scrpi/Fuzix-Compiler-Kit/docs/reference/isa-comparison.md

# BLIP ISA - cross-architecture syntax comparison

> **Non-normative.** A reference aid, not part of the justification chain (see [AGENTS.md](../AGENTS.md)). It names external architectures only for *syntax comparison*; nothing here justifies a BLIP decision.

Every BLIP opcode byte `0x00`-`0xFF` is listed; unused/reserved bytes show `-`. **Proposed** holds the agreed restyling of the BLIP cell (blank = no change); the rules are in the [Proposed](#proposed) section. Each used opcode is also translated into six other assembly languages, matched to that opcode's BLIP addressing mode.

**Legend:** `≈` = closest faithful multi-instruction equivalent; `—` = the ISA cannot express it directly. BLIP / 6502 / STM8 / Magic-1 use `$`-hex; 8080 / 8086 use Intel trailing-`h` hex. Generated from [isa.md](isa.md) §8; foreign columns adversarially cross-checked.

| Opcode | Operation | BLIP | Proposed | Z80 | STM8 | 6502 | Magic-1 | 8080 | 8086 |
|---|---|---|---|---|---|---|---|---|---|
| `0x00` | No-op | `NOP` | | `NOP` | `NOP` | `NOP` | `—` | `NOP` | `NOP` |
| `0x01` | Sync (priv) | `SYNC` | | `—` | `≈ WFI` | `—` | `—` | `—` | `—` |
| `0x02` | Decimal adjust | `DAA` | | `DAA` | `—` | `—` | `—` | `DAA` | `DAA` |
| `0x03` | Sign-extend B→A | `SEX` | | `≈ LD A,B:RLA:SBC A,A` | `≈ SEX X,A (B in A→XH=sign)` | `≈ LDA #0:CPX #$80:BCC +:LDA #$FF` | `sex a` | `≈ MOV A,B:RAL:SBB A` | `≈ CBW (B in AL)` |
| `0x04` | Multiply 8×8 (A*B→D) | `MUL` | | `—` | `MUL X,A` | `—` | `—` | `—` | `MUL BL` |
| `0x05` | Add B to X | `ABX` | | `≈ LD D,0:LD E,B:ADD IX,DE` | `≈ (B zero-ext→Y):ADDW X,Y(via mem)` | `—` | `≈ add.16 a,b (b zero-ext)` | `≈ MVI D,0:MOV E,B:DAD D` | `≈ MOV BH,0:ADD SI,BX` |
| `0x06` | Transfer reg→reg | `TFR D,X` | `LD X,D` | `≈ LD H,A:LD L,B:PUSH HL:POP IX` | `≈ LD XH,A:LD XL,B` | `—` | `≈ ld.16 a,b` | `≈ MOV H,A:MOV L,B` | `MOV SI,AX` |
| `0x07` | Exchange regs | `EXG A,B` | `XCHG A,B` | `≈ LD C,A:LD A,B:LD B,C` | `≈ EXG A,XL (B≈XL)` | `≈ STA t:TXA:LDX t (B≈X)` | `≈ ld.8 c,a:ld.8 a,b:ld.8 b,c` | `≈ MOV C,A:MOV A,B:MOV B,C` | `XCHG AL,BL` |
| `0x08` | Push register set | `PSHS A,B,X` | | `≈ PUSH AF:PUSH BC:PUSH IX` | `≈ PUSH A:(B→A:PUSH A):PUSHW X` | `≈ PHA:(B→A:PHA):TXA:PHA` | `≈ st.8 (sp),a;st.8 (sp),b;st.16 (sp),x` | `≈ PUSH PSW:PUSH B:PUSH H` | `≈ PUSH AX:PUSH BX:PUSH SI` |
| `0x09` | Pull register set | `PULS A,B,X` | | `≈ POP IX:POP BC:POP AF` | `≈ POPW X:(POP A→B):POP A` | `≈ PLA:TAX:(PLA→B):PLA` | `≈ ld.16 x,(sp);ld.8 b,(sp);ld.8 a,(sp)` | `≈ POP H:POP B:POP PSW` | `≈ POP SI:POP BX:POP AX` |
| `0x0A` | AND into CC | `ANDCC #$EF` | `ANDCC $EF` | `≈ PUSH AF:POP BC:LD A,C:AND $EF:LD C,A:PUSH BC:POP AF` | `≈ PUSH CC:POP A:AND A,#$EF:PUSH A:POP CC` | `≈ PHP:PLA:AND #$EF:PHA:PLP` | `≈ (MSW: and $EF)` | `≈ PUSH PSW:POP H:MOV A,L:ANI 0EFh:MOV L,A:PUSH H:POP PSW` | `≈ PUSHF:POP AX:AND AX,0FFEFh:PUSH AX:POPF` |
| `0x0B` | OR into CC | `ORCC #$10` | `ORCC $10` | `≈ PUSH AF:POP BC:LD A,C:OR $10:LD C,A:PUSH BC:POP AF` | `≈ PUSH CC:POP A:OR A,#$10:PUSH A:POP CC` | `≈ PHP:PLA:ORA #$10:PHA:PLP` | `≈ (MSW: or $10)` | `≈ PUSH PSW:POP H:MOV A,L:ORI 10h:MOV L,A:PUSH H:POP PSW`  | `≈ PUSHF:POP AX:OR AX,10h:PUSH AX:POPF` |
| `0x0C` | Mask interrupts (priv) | `SEI` | | `DI` | `SIM` | `SEI` | `≈ (MSW mask interrupts)` | `DI` | `CLI` |
| `0x0D` | Unmask interrupts (priv) | `CLI` | | `EI` | `RIM` | `CLI` | `≈ (MSW unmask interrupts)` | `EI` | `STI` |
| `0x0E` | - | - | | - | - | - | - | - | - |
| `0x0F` | - | - | | - | - | - | - | - | - |
| `0x10` | Return from subroutine | `RTS` | | `RET` | `RET` | `RTS` | `ret` | `RET` | `RET` |
| `0x11` | Return from interrupt (priv) | `RTI` | | `RETI` | `IRET` | `RTI` | `reti` | `≈ EI:RET` | `IRET` |
| `0x12` | Software trap | `SWI` | | `RST $38` | `TRAP` | `BRK` | `syscall 0` | `RST 7` | `INT 3` |
| `0x13` | Software trap 2 | `SWI2` | | `≈ RST $30` | `—` | `—` | `syscall 1` | `≈ RST 6` | `INT n` |
| `0x14` | Software trap 3 | `SWI3` | | `≈ RST $28` | `—` | `—` | `syscall 2` | `≈ RST 5` | `INT n` |
| `0x15` | Wait, clear CC mask | `CWAI #$EF` | `CWAI $EF` | `≈ (ANDCC $EF):HALT` | `≈ (ANDCC $EF):WFI` | `—` | `≈ (MSW: and $EF):halt` | `≈ EI:HLT` | `≈ STI:HLT` |
| `0x16` | Branch to subroutine | `BSR lbl` | | `CALL lbl` | `CALLR lbl` | `JSR lbl` | `call lbl` | `CALL lbl` | `CALL lbl` |
| `0x17` | Long branch to subroutine | `LBSR lbl` | | `CALL lbl` | `CALL lbl` | `JSR lbl` | `call lbl` | `CALL lbl` | `CALL lbl` |
| `0x18` | Halt (priv) | `HALT` | | `HALT` | `HALT` | `—` | `halt` | `HLT` | `HLT` |
| `0x19` | Test-and-set (atomic) | `TAS ,X` | `TAS (X)` | `—` | `—` | `—` | `ldclr a,(b)` | `—` | `≈ MOV AL,1:LOCK XCHG [BX],AL` |
| `0x1A` | Bank USP via TFR (priv) | `TFRU` | `LD USP,X` | `—` | `—` | `—` | `≈ ld ssp,a` | `—` | `—` |
| `0x1B` | Bank USP via EXG (priv) | `EXGU` | `XCHG X,USP` | `—` | `—` | `—` | `≈ (exch ssp,a via temp)` | `—` | `—` |
| `0x1C` | Load MMU entry (priv) | `LDMMU #2` | `LDMMU $2` | `—` | `—` | `—` | `≈ ld ptb,a / wcpte a,(b)` | `—` | `—` |
| `0x1D` | Store MMU entry (priv) | `STMMU #2` | `STMMU $2` | `—` | `—` | `—` | `—` | `—` | `—` |
| `0x1E` | - | - | | - | - | - | - | - | - |
| `0x1F` | - | - | | - | - | - | - | - | - |
| `0x20` | Branch always | `BRA lbl` | | `JR lbl` | `JRA lbl` | `JMP lbl` | `br lbl` | `JMP lbl` | `JMP lbl` |
| `0x21` | Branch never | `BRN lbl` | | `— (never)` | `JRF lbl` | `— (never)` | `— (no never)` | `— (never)` | `— (never)` |
| `0x22` | Branch unsigned &gt; | `BHI lbl` | | `—` | `JRUGT lbl` | `—` | `br.gtu lbl` | `≈ JC skip:JZ skip:JMP lbl` | `JA lbl` |
| `0x23` | Branch unsigned ≤ | `BLS lbl` | | `—` | `JRULE lbl` | `—` | `br.leu lbl` | `≈ JC lbl:JZ lbl` | `JBE lbl` |
| `0x24` | Branch carry clear (uns ≥) | `BCC lbl` | | `JR NC,lbl` | `JRNC lbl` | `BCC lbl` | `br.geu lbl` | `JNC lbl` | `JAE lbl` |
| `0x25` | Branch carry set (uns &lt;) | `BCS lbl` | | `JR C,lbl` | `JRC lbl` | `BCS lbl` | `br.ltu lbl` | `JC lbl` | `JB lbl` |
| `0x26` | Branch not equal | `BNE lbl` | | `JR NZ,lbl` | `JRNE lbl` | `BNE lbl` | `br.ne lbl` | `JNZ lbl` | `JNE lbl` |
| `0x27` | Branch equal | `BEQ lbl` | | `JR Z,lbl` | `JREQ lbl` | `BEQ lbl` | `br.eq lbl` | `JZ lbl` | `JE lbl` |
| `0x28` | Branch overflow clear | `BVC lbl` | | `JP PO,lbl` | `JRNV lbl` | `BVC lbl` | `—` | `JPO lbl` | `JNO lbl` |
| `0x29` | Branch overflow set | `BVS lbl` | | `JP PE,lbl` | `JRV lbl` | `BVS lbl` | `—` | `JPE lbl` | `JO lbl` |
| `0x2A` | Branch plus | `BPL lbl` | | `JP P,lbl` | `JRPL lbl` | `BPL lbl` | `≈ br.ge lbl` | `JP lbl` | `JNS lbl` |
| `0x2B` | Branch minus | `BMI lbl` | | `JP M,lbl` | `JRMI lbl` | `BMI lbl` | `≈ br.lt lbl` | `JM lbl` | `JS lbl` |
| `0x2C` | Branch signed ≥ | `BGE lbl` | | `—` | `JRSGE lbl` | `—` | `br.ge lbl` | `—` | `JGE lbl` |
| `0x2D` | Branch signed &lt; | `BLT lbl` | | `—` | `JRSLT lbl` | `—` | `br.lt lbl` | `—` | `JL lbl` |
| `0x2E` | Branch signed &gt; | `BGT lbl` | | `—` | `JRSGT lbl` | `—` | `br.gt lbl` | `—` | `JG lbl` |
| `0x2F` | Branch signed ≤ | `BLE lbl` | | `—` | `JRSLE lbl` | `—` | `br.le lbl` | `—` | `JLE lbl` |
| `0x30` | Load eff. addr → X | `LEAX 4,X` | `LEA X,X+4` | `≈ LD DE,4:ADD IX,DE` | `ADDW X,#4` | `—` | `lea a,(a+4)` | `≈ LXI D,4:DAD D (HL≈X)` | `LEA BX,[BX+4]` |
| `0x31` | Load eff. addr → Y | `LEAY 4,Y` | `LEA Y,Y+4` | `≈ LD DE,4:ADD IY,DE` | `ADDW Y,#4` | `—` | `lea a,(a+4)` | `—` | `LEA DI,[DI+4]` |
| `0x32` | Adjust SP | `LEASP -8,SP`  | `LEA SP,SP-8` | `≈ LD HL,-8:ADD HL,SP:LD SP,HL` | `—` | `≈ TSX:DEX×8:TXS` | `≈ sub.16 sp,$08` | `≈ LXI H,-8:DAD SP:SPHL` | `SUB SP,8` |
| `0x33` | Compare D (imm) | `CMPD #$1000`  | `CMP D,$1000` | `—` | `≈ LDW X,D:CPW X,#$1000` | `—` | `≈ ld.16 a,d:cmp.16 a,$1000` | `—` | `CMP DX,1000h` |
| `0x34` | Compare Y (imm) | `CMPY #$1000`  | `CMP Y,$1000` | `—` | `CPW Y,#$1000` | `—` | `≈ ld.16 a,y:cmp.16 a,$1000` | `—` | `CMP DI,1000h` |
| `0x35` | Compare SP (imm) | `CMPSP #$1000` | `CMP SP,$1000` | `—` | `—` | `—` | `≈ ld.16 a,sp:cmp.16 a,$1000` | `—` | `CMP SP,1000h` |
| `0x36` | Jump (indexed) | `JMP ,X` | `JMP X` | `JP (IX)` | `JP (X)` | `—` | `≈ br a` | `PCHL (HL≈X)` | `JMP BX` |
| `0x37` | Jump (extended) | `JMP $1234` | | `JP $1234` | `JP $1234` | `JMP $1234` | `br $1234` | `JMP 1234h` | `JMP 1234h` |
| `0x38` | Compare D (indexed) | `CMPD 6,X` | `CMP D,(X+6)` | `—` | `≈ LDW Y,D:CPW Y,(6,X)` | `—` | `≈ ld.16 a,d:cmp.16 a,(b+6)` | `—` | `CMP DX,[BX+6]` |
| `0x39` | Compare D (extended) | `CMPD $1234` | `CMP D,($1234)`  | `—` | `≈ LDW X,D:CPW X,$1234` | `—` | `≈ ld.16 a,d:cmp.16 a,(dp+$1234)` | `—` | `CMP DX,[1234h]` |
| `0x3A` | Compare Y (indexed) | `CMPY 6,X` | `CMP Y,(X+6)` | `—` | `CPW Y,(6,X)` | `—` | `≈ ld.16 a,y:cmp.16 a,(b+6)` | `—` | `CMP DI,[BX+6]` |
| `0x3B` | Compare Y (extended) | `CMPY $1234` | `CMP Y,($1234)`  | `—` | `CPW Y,$1234` | `—` | `≈ ld.16 a,y:cmp.16 a,(dp+$1234)` | `—` | `CMP DI,[1234h]` |
| `0x3C` | Compare SP (indexed) | `CMPSP 6,X` | `CMP SP,(X+6)` | `—` | `—` | `—` | `≈ ld.16 a,sp:cmp.16 a,(b+6)` | `—` | `CMP SP,[BX+6]` |
| `0x3D` | Compare SP (extended) | `CMPSP $1234`  | `CMP SP,($1234)` | `—` | `—` | `—` | `≈ ld.16 a,sp:cmp.16 a,(dp+$1234)` | `—` | `CMP SP,[1234h]` |
| `0x3E` | - | - | | - | - | - | - | - | - |
| `0x3F` | - | - | | - | - | - | - | - | - |
| `0x40` | Negate A | `NEGA` | `NEG A` | `NEG` | `NEG A` | `≈ EOR #$FF:CLC:ADC #1` | `≈ xor.8 a,$FF:add.8 a,$01` | `≈ CMA:INR A` | `NEG AL` |
| `0x41` | - | - | | - | - | - | - | - | - |
| `0x42` | - | - | | - | - | - | - | - | - |
| `0x43` | Complement A | `COMA` | `COM A` | `CPL` | `CPL A` | `EOR #$FF` | `xor.8 a,$FF` | `CMA` | `NOT AL` |
| `0x44` | Logical shift right A | `LSRA` | `LSR A` | `SRL A` | `SRL A` | `LSR A` | `shr.8 a,$01` | `≈ ORA A:RAR` | `SHR AL,1` |
| `0x45` | - | - | | - | - | - | - | - | - |
| `0x46` | Rotate right thru C A | `RORA` | `ROR A` | `RR A` | `RRC A` | `ROR A` | `—` | `RAR` | `RCR AL,1` |
| `0x47` | Arith shift right A | `ASRA` | `ASR A` | `SRA A` | `SRA A` | `—` | `—` | `≈ rotates` | `SAR AL,1` |
| `0x48` | Shift left A | `ASLA` | `ASL A` | `SLA A` | `SLL A` | `ASL A` | `shl.8 a,$01` | `≈ ADD A` | `SHL AL,1` |
| `0x49` | Rotate left thru C A | `ROLA` | `ROL A` | `RL A` | `RLC A` | `ROL A` | `—` | `RAL` | `RCL AL,1` |
| `0x4A` | Decrement A | `DECA` | `DEC A` | `DEC A` | `DEC A` | `≈ TAX:DEX:TXA` | `≈ sub.8 a,$01` | `DCR A` | `DEC AL` |
| `0x4B` | - | - | | - | - | - | - | - | - |
| `0x4C` | Increment A | `INCA` | `INC A` | `INC A` | `INC A` | `≈ TAX:INX:TXA` | `≈ add.8 a,$01` | `INR A` | `INC AL` |
| `0x4D` | Test (set N,Z) A | `TSTA` | `TST A` | `OR A` | `TNZ A` | `≈ CMP #0` | `≈ cmp.8 a,$00` | `ORA A` | `TEST AL,AL` |
| `0x4E` | - | - | | - | - | - | - | - | - |
| `0x4F` | Clear A | `CLRA` | `CLR A` | `XOR A` | `CLR A` | `LDA #0` | `ld.8 a,$00` | `XRA A` | `XOR AL,AL` |
| `0x50` | Negate B | `NEGB` | `NEG B` | `≈ LD A,B:NEG:LD B,A` | `≈ NEG A` | `≈ TXA:EOR #$FF:CLC:ADC #1:TAX` | `≈ xor.8 b,$FF:add.8 b,$01` | `≈ MOV A,B:CMA:INR A:MOV B,A` | `NEG BL` |
| `0x51` | - | - | | - | - | - | - | - | - |
| `0x52` | - | - | | - | - | - | - | - | - |
| `0x53` | Complement B | `COMB` | `COM B` | `≈ LD A,B:CPL:LD B,A` | `≈ CPL A` | `≈ TXA:EOR #$FF:TAX` | `xor.8 b,$FF` | `≈ MOV A,B:CMA:MOV B,A` | `NOT BL` |
| `0x54` | Logical shift right B | `LSRB` | `LSR B` | `≈ LD A,B:SRL A:LD B,A` | `≈ SRL A` | `≈ TXA:LSR A:TAX` | `shr.8 b,$01` | `≈ MOV A,B:ORA A:RAR:MOV B,A` | `SHR BL,1` |
| `0x55` | - | - | | - | - | - | - | - | - |
| `0x56` | Rotate right thru C B | `RORB` | `ROR B` | `≈ LD A,B:RR A:LD B,A` | `≈ RRC A` | `≈ TXA:ROR A:TAX` | `—` | `≈ MOV A,B:RAR:MOV B,A` | `RCR BL,1` |
| `0x57` | Arith shift right B | `ASRB` | `ASR B` | `≈ LD A,B:SRA A:LD B,A` | `≈ SRA A` | `—` | `—` | `≈ rotates` | `SAR BL,1` |
| `0x58` | Shift left B | `ASLB` | `ASL B` | `≈ LD A,B:SLA A:LD B,A` | `≈ SLL A` | `≈ TXA:ASL A:TAX` | `shl.8 b,$01` | `≈ MOV A,B:ADD A:MOV B,A` | `SHL BL,1` |
| `0x59` | Rotate left thru C B | `ROLB` | `ROL B` | `≈ LD A,B:RL A:LD B,A` | `≈ RLC A` | `≈ TXA:ROL A:TAX` | `—` | `≈ MOV A,B:RAL:MOV B,A` | `RCL BL,1` |
| `0x5A` | Decrement B | `DECB` | `DEC B` | `DEC B` | `≈ DEC A` | `DEX` | `≈ sub.8 b,$01` | `DCR B` | `DEC BL` |
| `0x5B` | - | - | | - | - | - | - | - | - |
| `0x5C` | Increment B | `INCB` | `INC B` | `INC B` | `≈ INC A` | `INX` | `≈ add.8 b,$01` | `INR B` | `INC BL` |
| `0x5D` | Test (set N,Z) B | `TSTB` | `TST B` | `≈ LD A,B:OR A` | `≈ TNZ A` | `≈ CPX #0` | `≈ cmp.8 b,$00` | `≈ MOV A,B:ORA A` | `TEST BL,BL` |
| `0x5E` | - | - | | - | - | - | - | - | - |
| `0x5F` | Clear B | `CLRB` | `CLR B` | `≈ LD B,0` | `≈ CLR A` | `LDX #0` | `ld.8 b,$00` | `MVI B,0` | `XOR BL,BL` |
| `0x60` | Negate (indexed) | `NEG 6,X` | `NEG (X+6)` | `≈ LD A,(IX+6):NEG:LD (IX+6),A` | `NEG (6,X)` | `≈ SEC:LDA $06,X:EOR #$FF:ADC #1:STA $06,X` | `≈ ld.8 a,$00:sub.8 a,(b+6):st.8 (b+6),a` | `≈ LXI H,..:MOV A,M:CMA:INR A:MOV M,A` | `NEG byte [BX+6]` |
| `0x61` | - | - | | - | - | - | - | - | - |
| `0x62` | - | - | | - | - | - | - | - | - |
| `0x63` | Complement (indexed) | `COM 6,X` | `COM (X+6)` | `≈ LD A,(IX+6):CPL:LD (IX+6),A` | `CPL (6,X)` | `≈ LDA $06,X:EOR #$FF:STA $06,X` | `≈ ld.8 a,(b+6):xor.8 a,$FF:st.8 (b+6),a` | `≈ LXI H,..:MOV A,M:CMA:MOV M,A` | `NOT byte [BX+6]` |
| `0x64` | Logical shift right (indexed) | `LSR 6,X` | `LSR (X+6)` | `SRL (IX+6)` | `SRL (6,X)` | `LSR $06,X` | `≈ ld.8 a,(b+6):shr.8 a:st.8 (b+6),a` | `≈ LXI H,..:MOV A,M:ORA A:RAR:MOV M,A` | `SHR byte [BX+6],1` |
| `0x65` | - | - | | - | - | - | - | - | - |
| `0x66` | Rotate right thru C (indexed) | `ROR 6,X` | `ROR (X+6)` | `RR (IX+6)` | `RRC (6,X)` | `ROR $06,X` | `—` | `≈ LXI H,..:MOV A,M:RAR:MOV M,A` | `RCR byte [BX+6],1` |
| `0x67` | Arith shift right (indexed) | `ASR 6,X` | `ASR (X+6)` | `SRA (IX+6)` | `SRA (6,X)` | `—` | `≈ shr.8 then restore sign bit` | `≈ rotates (no SAR)` | `SAR byte [BX+6],1` |
| `0x68` | Shift left (indexed) | `ASL 6,X` | `ASL (X+6)` | `SLA (IX+6)` | `SLL (6,X)` | `ASL $06,X` | `≈ ld.8 a,(b+6):shl.8 a:st.8 (b+6),a` | `≈ LXI H,..:MOV A,M:ADD A:MOV M,A` | `SHL byte [BX+6],1` |
| `0x69` | Rotate left thru C (indexed) | `ROL 6,X` | `ROL (X+6)` | `RL (IX+6)` | `RLC (6,X)` | `ROL $06,X` | `—` | `≈ LXI H,..:MOV A,M:RAL:MOV M,A` | `RCL byte [BX+6],1` |
| `0x6A` | Decrement (indexed) | `DEC 6,X` | `DEC (X+6)` | `DEC (IX+6)` | `DEC (6,X)` | `DEC $06,X` | `≈ ld.8 a,(b+6):sub.8 a,$01:st.8 (b+6),a` | `≈ LXI H,..:DCR M` | `DEC byte [BX+6]` |
| `0x6B` | - | - | | - | - | - | - | - | - |
| `0x6C` | Increment (indexed) | `INC 6,X` | `INC (X+6)` | `INC (IX+6)` | `INC (6,X)` | `INC $06,X` | `≈ ld.8 a,(b+6):add.8 a,$01:st.8 (b+6),a` | `≈ LXI H,..:INR M` | `INC byte [BX+6]` |
| `0x6D` | Test (set N,Z) (indexed) | `TST 6,X` | `TST (X+6)` | `≈ LD A,(IX+6):OR A` | `TNZ (6,X)` | `≈ LDA $06,X (sets N,Z)` | `≈ ld.8 a,(b+6):or.8 a,a` | `≈ LXI H,..:MOV A,M:ORA A` | `≈ MOV AL,[BX+6]:TEST AL,AL` |
| `0x6E` | - | - | | - | - | - | - | - | - |
| `0x6F` | Clear (indexed) | `CLR 6,X` | `CLR (X+6)` | `≈ LD (IX+6),0` | `CLR (6,X)` | `≈ LDA #0:STA $06,X` | `≈ ld.8 a,$00:st.8 (b+6),a` | `≈ LXI H,..:MVI M,0` | `MOV byte [BX+6],0` |
| `0x70` | Negate (extended) | `NEG $1234` | `NEG ($1234)` | `≈ LD A,($1234):NEG:LD ($1234),A` | `NEG $1234` | `≈ SEC:LDA $1234:EOR #$FF:ADC #1:STA $1234` | `≈ ld.8 a,$00:sub.8 a,(dp+$1234):st.8 (dp+$1234),a` | `≈ LDA $1234:CMA:INR A:STA $1234` | `NEG byte [1234h]` |
| `0x71` | - | - | | - | - | - | - | - | - |
| `0x72` | - | - | | - | - | - | - | - | - |
| `0x73` | Complement (extended) | `COM $1234` | `COM ($1234)` | `≈ LD A,($1234):CPL:LD ($1234),A` | `CPL $1234` | `≈ LDA $1234:EOR #$FF:STA $1234` | `≈ ld.8 a,(dp+$1234):xor.8 a,$FF:st.8 (dp+$1234),a` | `≈ LDA $1234:CMA:STA $1234` | `NOT byte [1234h]` |
| `0x74` | Logical shift right (extended) | `LSR $1234` | `LSR ($1234)` | `≈ LD HL,$1234:SRL (HL)` | `SRL $1234` | `LSR $1234` | `≈ ld.8 a,(dp+$1234):shr.8 a:st.8 (dp+$1234),a` | `≈ LDA $1234:ORA A:RAR:STA $1234` | `SHR byte [1234h],1` |
| `0x75` | - | - | | - | - | - | - | - | - |
| `0x76` | Rotate right thru C (extended) | `ROR $1234` | `ROR ($1234)` | `≈ LD HL,$1234:RR (HL)` | `RRC $1234` | `ROR $1234` | `—` | `≈ LDA $1234:RAR:STA $1234` | `RCR byte [1234h],1` |
| `0x77` | Arith shift right (extended) | `ASR $1234` | `ASR ($1234)` | `≈ LD HL,$1234:SRA (HL)` | `SRA $1234` | `—` | `≈ shr.8 then restore sign bit` | `≈ rotates (no SAR)` | `SAR byte [1234h],1` |
| `0x78` | Shift left (extended) | `ASL $1234` | `ASL ($1234)` | `≈ LD HL,$1234:SLA (HL)` | `SLL $1234` | `ASL $1234` | `≈ ld.8 a,(dp+$1234):shl.8 a:st.8 (dp+$1234),a` | `≈ LDA $1234:ADD A:STA $1234` | `SHL byte [1234h],1` |
| `0x79` | Rotate left thru C (extended) | `ROL $1234` | `ROL ($1234)` | `≈ LD HL,$1234:RL (HL)` | `RLC $1234` | `ROL $1234` | `—` | `≈ LDA $1234:RAL:STA $1234` | `RCL byte [1234h],1` |
| `0x7A` | Decrement (extended) | `DEC $1234` | `DEC ($1234)` | `≈ LD HL,$1234:DEC (HL)` | `DEC $1234` | `DEC $1234` | `≈ ld.8 a,(dp+$1234):sub.8 a,$01:st.8 (dp+$1234),a` | `≈ LXI H,$1234:DCR M` | `DEC byte [1234h]` |
| `0x7B` | - | - | | - | - | - | - | - | - |
| `0x7C` | Increment (extended) | `INC $1234` | `INC ($1234)` | `≈ LD HL,$1234:INC (HL)` | `INC $1234` | `INC $1234` | `≈ ld.8 a,(dp+$1234):add.8 a,$01:st.8 (dp+$1234),a` | `≈ LXI H,$1234:INR M` | `INC byte [1234h]` |
| `0x7D` | Test (set N,Z) (extended) | `TST $1234` | `TST ($1234)` | `≈ LD A,($1234):OR A` | `TNZ $1234` | `≈ LDA $1234 (sets N,Z)` | `≈ ld.8 a,(dp+$1234):or.8 a,a` | `≈ LDA $1234:ORA A` | `≈ MOV AL,[1234h]:TEST AL,AL` |
| `0x7E` | - | - | | - | - | - | - | - | - |
| `0x7F` | Clear (extended) | `CLR $1234` | `CLR ($1234)` | `≈ LD HL,$1234:LD (HL),0` | `CLR $1234` | `≈ LDA #0:STA $1234` | `≈ ld.8 a,$00:st.8 (dp+$1234),a` | `≈ XRA A:STA $1234` | `MOV byte [1234h],0` |
| `0x80` | Subtract A (imm) | `SUBA #$05` | `SUB A,$05` | `SUB $05` | `SUB A,#$05` | `≈ SEC:SBC #$05` | `sub.8 a,$05` | `SUI 05h` | `SUB AL,5` |
| `0x81` | Compare A (imm) | `CMPA #$05` | `CMP A,$05` | `CP $05` | `CP A,#$05` | `CMP #$05` | `cmp.8 a,$05` | `CPI 05h` | `CMP AL,5` |
| `0x82` | Sub-borrow A (imm) | `SBCA #$05` | `SBC A,$05` | `SBC A,$05` | `SBC A,#$05` | `SBC #$05` | `sbc.8 a,$05` | `SBI 05h` | `SBB AL,5` |
| `0x83` | Subtract D (imm) | `SUBD #$1000`  | `SUB D,$1000` | `≈ LD DE,$1000:OR A:SBC HL,DE` | `SUBW X,#$1000` | `—` | `sub.16 a,$1000` | `—` | `SUB AX,1000h` |
| `0x84` | AND A (imm) | `ANDA #$05` | `AND A,$05` | `AND $05` | `AND A,#$05` | `AND #$05` | `and.8 a,$05` | `ANI 05h` | `AND AL,5` |
| `0x85` | Bit test A (imm) | `BITA #$05` | `BIT A,$05` | `AND $05` | `BCP A,#$05` | `—` | `and.8 a,$05` | `ANI 05h` | `TEST AL,5` |
| `0x86` | Load A (imm) | `LDA #$05` | `LD A,$05` | `LD A,$05` | `LD A,#$05` | `LDA #$05` | `ld.8 a,$05` | `MVI A,05h` | `MOV AL,5` |
| `0x87` | - | - | | - | - | - | - | - | - |
| `0x88` | EOR A (imm) | `EORA #$05` | `EOR A,$05` | `XOR $05` | `XOR A,#$05` | `EOR #$05` | `xor.8 a,$05` | `XRI 05h` | `XOR AL,5` |
| `0x89` | Add-carry A (imm) | `ADCA #$05` | `ADC A,$05` | `ADC A,$05` | `ADC A,#$05` | `≈ ADC #$05 (carry-add)` | `adc.8 a,$05` | `ACI 05h` | `ADC AL,5` |
| `0x8A` | OR A (imm) | `ORA #$05` | `OR A,$05` | `OR $05` | `OR A,#$05` | `ORA #$05` | `or.8 a,$05` | `ORI 05h` | `OR AL,5` |
| `0x8B` | Add A (imm) | `ADDA #$05` | `ADD A,$05` | `ADD A,$05` | `ADD A,#$05` | `≈ CLC:ADC #$05` | `add.8 a,$05` | `ADI 05h` | `ADD AL,5` |
| `0x8C` | Compare X (imm) | `CMPX #$1000`  | `CMP X,$1000` | `—` | `CPW X,#$1000` | `—` | `cmp.16 a,$1000` | `—` | `CMP AX,1000h` |
| `0x8D` | - | - | | - | - | - | - | - | - |
| `0x8E` | Load X (imm) | `LDX #$1234` | `LD X,$1234` | `LD IX,$1234` | `LDW X,#$1234` | `—` | `ld.16 a,$1234` | `LXI H,1234h` | `MOV SI,1234h` |
| `0x8F` | - | - | | - | - | - | - | - | - |
| `0x90` | Subtract A (indexed) | `SUBA 6,X` | `SUB A,(X+6)` | `SUB (IX+6)` | `SUB A,(6,X)` | `≈ SEC:SBC $06,X` | `≈ ld.8 b,(b+6):sub.8 a,b` | `≈ LXI H,addr:SUB M` | `SUB AL,[SI+6]` |
| `0x91` | Compare A (indexed) | `CMPA 6,X` | `CMP A,(X+6)` | `CP (IX+6)` | `CP A,(6,X)` | `CMP $06,X` | `≈ ld.8 b,(b+6):cmp.8 a,b` | `≈ LXI H,addr:CMP M` | `CMP AL,[SI+6]` |
| `0x92` | Sub-borrow A (indexed) | `SBCA 6,X` | `SBC A,(X+6)` | `SBC A,(IX+6)` | `SBC A,(6,X)` | `SBC $06,X` | `≈ ld.8 b,(b+6):sbc.8 a,b` | `≈ LXI H,addr:SBB M` | `SBB AL,[SI+6]` |
| `0x93` | Subtract D (indexed) | `SUBD 6,X` | `SUB D,(X+6)` | `—` | `SUBW X,(6,X)` | `—` | `≈ ld.16 b,(b+6):sub.16 a,b` | `—` | `SUB AX,[SI+6]` |
| `0x94` | AND A (indexed) | `ANDA 6,X` | `AND A,(X+6)` | `AND (IX+6)` | `AND A,(6,X)` | `AND $06,X` | `≈ ld.8 b,(b+6):and.8 a,b` | `≈ LXI H,addr:ANA M` | `AND AL,[SI+6]` |
| `0x95` | Bit test A (indexed) | `BITA 6,X` | `BIT A,(X+6)` | `AND (IX+6)` | `≈ LD A,(6,X):BCP A,..` | `—` | `≈ ld.8 b,(b+6):and.8 a,b` | `≈ LXI H,addr:ANA M` | `TEST AL,[SI+6]` |
| `0x96` | Load A (indexed) | `LDA 6,X` | `LD A,(X+6)` | `LD A,(IX+6)` | `LD A,(6,X)` | `LDA $06,X` | `ld.8 a,(b+6)` | `≈ LXI H,addr:MOV A,M` | `MOV AL,[SI+6]` |
| `0x97` | Store A (indexed) | `STA 6,X` | `ST A,(X+6)` | `LD (IX+6),A` | `LD (6,X),A` | `STA $06,X` | `st.8 (b+6),a` | `≈ LXI H,addr:MOV M,A` | `MOV [SI+6],AL` |
| `0x98` | EOR A (indexed) | `EORA 6,X` | `EOR A,(X+6)` | `XOR (IX+6)` | `XOR A,(6,X)` | `EOR $06,X` | `≈ ld.8 b,(b+6):xor.8 a,b` | `≈ LXI H,addr:XRA M` | `XOR AL,[SI+6]` |
| `0x99` | Add-carry A (indexed) | `ADCA 6,X` | `ADC A,(X+6)` | `ADC A,(IX+6)` | `ADC A,(6,X)` | `ADC $06,X` | `≈ ld.8 b,(b+6):adc.8 a,b` | `≈ LXI H,addr:ADC M` | `ADC AL,[SI+6]` |
| `0x9A` | OR A (indexed) | `ORA 6,X` | `OR A,(X+6)` | `OR (IX+6)` | `OR A,(6,X)` | `ORA $06,X` | `≈ ld.8 b,(b+6):or.8 a,b` | `≈ LXI H,addr:ORA M` | `OR AL,[SI+6]` |
| `0x9B` | Add A (indexed) | `ADDA 6,X` | `ADD A,(X+6)` | `ADD A,(IX+6)` | `ADD A,(6,X)` | `≈ CLC:ADC $06,X` | `≈ ld.8 b,(b+6):add.8 a,b` | `≈ LXI H,addr:ADD M` | `ADD AL,[SI+6]` |
| `0x9C` | Compare X (indexed) | `CMPX 6,X` | `CMP X,(X+6)` | `—` | `CPW X,(6,X)` | `—` | `≈ ld.16 b,(b+6):cmp.16 a,b` | `—` | `CMP AX,[SI+6]` |
| `0x9D` | Jump subroutine (indexed) | `JSR ,X` | `JSR X` | `≈ push ret-addr:JP (IX)` | `CALL (X)` | `—` | `call a` | `≈ PCHL (jump only; no ind CALL)` | `CALL SI` |
| `0x9E` | Load X (indexed) | `LDX 6,X` | `LD X,(X+6)` | `≈ LD L,(IX+6):LD H,(IX+7)` | `LDW X,(6,X)` | `—` | `ld.16 a,(b+6)` | `≈ LXI H,addr:MOV E,M:INX H:MOV D,M` | `MOV SI,[SI+6]` |
| `0x9F` | Store X (indexed) | `STX 6,X` | `ST X,(X+6)` | `≈ LD (IX+6),L:LD (IX+7),H` | `≈ LDW Y,X:LDW (6,X),Y` | `—` | `st.16 (b+6),a` | `≈ LXI H,addr:MOV M,E:INX H:MOV M,D` | `MOV [SI+6],SI` |
| `0xA0` | Subtract A (extended) | `SUBA $1234` | `SUB A,($1234)`  | `≈ LD HL,$1234:SUB (HL)` | `SUB A,$1234` | `≈ SEC:SBC $1234` | `sub.8 a,(dp+$1234)` | `≈ LXI H,$1234:SUB M` | `SUB AL,[1234h]` |
| `0xA1` | Compare A (extended) | `CMPA $1234` | `CMP A,($1234)`  | `≈ LD HL,$1234:CP (HL)` | `CP A,$1234` | `CMP $1234` | `cmp.8 a,(dp+$1234)` | `≈ LXI H,$1234:CMP M` | `CMP AL,[1234h]` |
| `0xA2` | Sub-borrow A (extended) | `SBCA $1234` | `SBC A,($1234)`  | `≈ LD HL,$1234:SBC A,(HL)` | `SBC A,$1234` | `SBC $1234` | `sbc.8 a,(dp+$1234)` | `≈ LXI H,$1234:SBB M` | `SBB AL,[1234h]` |
| `0xA3` | Subtract D (extended) | `SUBD $1234` | `SUB D,($1234)`  | `≈ LD DE,($1234):OR A:SBC HL,DE` | `—` | `—` | `sub.16 a,(dp+$1234)` | `—` | `SUB AX,[1234h]` |
| `0xA4` | AND A (extended) | `ANDA $1234` | `AND A,($1234)`  | `≈ LD HL,$1234:AND (HL)` | `AND A,$1234` | `AND $1234` | `and.8 a,(dp+$1234)` | `≈ LXI H,$1234:ANA M` | `AND AL,[1234h]` |
| `0xA5` | Bit test A (extended) | `BITA $1234` | `BIT A,($1234)`  | `≈ LD HL,$1234:AND (HL) (destroys A)` | `BCP A,$1234` | `BIT $1234` | `≈ and.8 a,(dp+$1234) (destroys a)` | `≈ LXI H,$1234:ANA M` | `TEST AL,[1234h]` |
| `0xA6` | Load A (extended) | `LDA $1234` | `LD A,($1234)` | `LD A,($1234)` | `LD A,$1234` | `LDA $1234` | `ld.8 a,(dp+$1234)` | `LDA $1234` | `MOV AL,[1234h]` |
| `0xA7` | Store A (extended) | `STA $1234` | `ST A,($1234)` | `LD ($1234),A` | `LD $1234,A` | `STA $1234` | `st.8 (dp+$1234),a` | `STA $1234` | `MOV [1234h],AL` |
| `0xA8` | EOR A (extended) | `EORA $1234` | `EOR A,($1234)`  | `≈ LD HL,$1234:XOR (HL)` | `XOR A,$1234` | `EOR $1234` | `xor.8 a,(dp+$1234)` | `≈ LXI H,$1234:XRA M` | `XOR AL,[1234h]` |
| `0xA9` | Add-carry A (extended) | `ADCA $1234` | `ADC A,($1234)`  | `≈ LD HL,$1234:ADC A,(HL)` | `ADC A,$1234` | `ADC $1234` | `adc.8 a,(dp+$1234)` | `≈ LXI H,$1234:ADC M` | `ADC AL,[1234h]` |
| `0xAA` | OR A (extended) | `ORA $1234` | `OR A,($1234)` | `≈ LD HL,$1234:OR (HL)` | `OR A,$1234` | `ORA $1234` | `or.8 a,(dp+$1234)` | `≈ LXI H,$1234:ORA M` | `OR AL,[1234h]` |
| `0xAB` | Add A (extended) | `ADDA $1234` | `ADD A,($1234)`  | `≈ LD HL,$1234:ADD A,(HL)` | `ADD A,$1234` | `≈ CLC:ADC $1234` | `add.8 a,(dp+$1234)` | `≈ LXI H,$1234:ADD M` | `ADD AL,[1234h]` |
| `0xAC` | Compare X (extended) | `CMPX $1234` | `CMP X,($1234)`  | `—` | `CPW X,$1234` | `—` | `cmp.16 a,(dp+$1234)` | `—` | `CMP SI,[1234h]` |
| `0xAD` | Jump subroutine (extended) | `JSR $1234` | | `CALL $1234` | `CALL $1234` | `JSR $1234` | `call $1234` | `CALL $1234` | `CALL 1234h` |
| `0xAE` | Load X (extended) | `LDX $1234` | `LD X,($1234)` | `LD IX,($1234)` | `LDW X,$1234` | `≈ LDX $1234:LDY $1235` | `ld.16 a,(dp+$1234)` | `LHLD $1234` | `MOV SI,[1234h]` |
| `0xAF` | Store X (extended) | `STX $1234` | `ST X,($1234)` | `LD ($1234),IX` | `LDW $1234,X` | `≈ STX $1234:STY $1235` | `st.16 (dp+$1234),a` | `SHLD $1234` | `MOV [1234h],SI` |
| `0xB0` | Long branch always | `LBRA lbl` | | `JP lbl` | `JRA lbl` | `JMP lbl` | `br lbl` | `JMP lbl` | `JMP lbl` |
| `0xB1` | Long branch never | `LBRN lbl` | | `— (never)` | `JRF lbl` | `— (never)` | `— (never)` | `— (never)` | `— (never)` |
| `0xB2` | Long branch unsigned &gt; | `LBHI lbl` | | `—` | `JRUGT lbl` | `—` | `br.gtu lbl` | `≈ JZ skip:JNC lbl` | `JA lbl` |
| `0xB3` | Long branch unsigned ≤ | `LBLS lbl` | | `—` | `JRULE lbl` | `—` | `br.leu lbl` | `≈ JC lbl:JZ lbl` | `JBE lbl` |
| `0xB4` | Long branch carry clear (uns ≥)  | `LBCC lbl` | | `JR NC,lbl` | `JRNC lbl` | `BCC lbl` | `br.geu lbl` | `JNC lbl` | `JAE lbl` |
| `0xB5` | Long branch carry set (uns &lt;) | `LBCS lbl` | | `JR C,lbl` | `JRC lbl` | `BCS lbl` | `br.ltu lbl` | `JC lbl` | `JB lbl` |
| `0xB6` | Long branch not equal | `LBNE lbl` | | `JR NZ,lbl` | `JRNE lbl` | `BNE lbl` | `br.ne lbl` | `JNZ lbl` | `JNE lbl` |
| `0xB7` | Long branch equal | `LBEQ lbl` | | `JR Z,lbl` | `JREQ lbl` | `BEQ lbl` | `br.eq lbl` | `JZ lbl` | `JE lbl` |
| `0xB8` | Long branch overflow clear | `LBVC lbl` | | `JP PO,lbl` | `JRNV lbl` | `BVC lbl` | `—` | `JPO lbl` | `JNO lbl` |
| `0xB9` | Long branch overflow set | `LBVS lbl` | | `JP PE,lbl` | `JRV lbl` | `BVS lbl` | `—` | `JPE lbl` | `JO lbl` |
| `0xBA` | Long branch plus | `LBPL lbl` | | `JP P,lbl` | `JRPL lbl` | `BPL lbl` | `—` | `JP lbl` | `JNS lbl` |
| `0xBB` | Long branch minus | `LBMI lbl` | | `JP M,lbl` | `JRMI lbl` | `BMI lbl` | `—` | `JM lbl` | `JS lbl` |
| `0xBC` | Long branch signed ≥ | `LBGE lbl` | | `—` | `JRSGE lbl` | `—` | `br.ge lbl` | `—` | `JGE lbl` |
| `0xBD` | Long branch signed &lt; | `LBLT lbl` | | `—` | `JRSLT lbl` | `—` | `br.lt lbl` | `—` | `JL lbl` |
| `0xBE` | Long branch signed &gt; | `LBGT lbl` | | `—` | `JRSGT lbl` | `—` | `br.gt lbl` | `—` | `JG lbl` |
| `0xBF` | Long branch signed ≤ | `LBLE lbl` | | `—` | `JRSLE lbl` | `—` | `br.le lbl` | `—` | `JLE lbl` |
| `0xC0` | Subtract B (imm) | `SUBB #$05` | `SUB B,$05` | `≈ LD A,B:SUB 5:LD B,A` | `≈ SUB A,#$05 (A=B)` | `≈ TXA:SEC:SBC #$05:TAX (B≈X)` | `sub.8 b,$05` | `≈ MOV A,B:SUI 05h:MOV B,A` | `SUB BL,5` |
| `0xC1` | Compare B (imm) | `CMPB #$05` | `CMP B,$05` | `≈ LD A,B:CP 5` | `≈ CP A,#$05 (A=B)` | `CPX #$05 (B≈X)` | `cmp.8 b,$05` | `≈ MOV A,B:CPI 05h` | `CMP BL,5` |
| `0xC2` | Sub-borrow B (imm) | `SBCB #$05` | `SBC B,$05` | `≈ LD A,B:SBC A,5:LD B,A` | `≈ SBC A,#$05 (A=B)` | `≈ TXA:SBC #$05:TAX (B≈X)` | `sbc.8 b,$05` | `≈ MOV A,B:SBI 05h:MOV B,A` | `SBB BL,5` |
| `0xC3` | Add D (imm) | `ADDD #$1000`  | `ADD D,$1000` | `≈ LD DE,$1000:ADD HL,DE (D=HL)` | `ADDW X,#$1000 (D≈X)` | `—` | `add.16 a,$1000` | `≈ LXI D,1000h:DAD D (D=HL)` | `ADD AX,1000h` |
| `0xC4` | AND B (imm) | `ANDB #$05` | `AND B,$05` | `≈ LD A,B:AND 5:LD B,A` | `≈ AND A,#$05 (A=B)` | `≈ TXA:AND #$05:TAX (B≈X)` | `and.8 b,$05` | `≈ MOV A,B:ANI 05h:MOV B,A` | `AND BL,5` |
| `0xC5` | Bit test B (imm) | `BITB #$05` | `BIT B,$05` | `≈ LD A,B:AND 5` | `≈ BCP A,#$05 (A=B)` | `≈ TXA:AND #$05 (B≈X)` | `≈ and.8 b,$05 (sets flags)` | `≈ MOV A,B:ANI 05h` | `TEST BL,5` |
| `0xC6` | Load B (imm) | `LDB #$05` | `LD B,$05` | `LD B,5` | `≈ LD A,#$05 (A=B)` | `LDX #$05 (B≈X)` | `ld.8 b,$05` | `MVI B,05h` | `MOV BL,5` |
| `0xC7` | - | - | | - | - | - | - | - | - |
| `0xC8` | EOR B (imm) | `EORB #$05` | `EOR B,$05` | `≈ LD A,B:XOR 5:LD B,A` | `≈ XOR A,#$05 (A=B)` | `≈ TXA:EOR #$05:TAX (B≈X)` | `xor.8 b,$05` | `≈ MOV A,B:XRI 05h:MOV B,A` | `XOR BL,5` |
| `0xC9` | Add-carry B (imm) | `ADCB #$05` | `ADC B,$05` | `≈ LD A,B:ADC A,5:LD B,A` | `≈ ADC A,#$05 (A=B)` | `≈ TXA:ADC #$05:TAX (B≈X)` | `adc.8 b,$05` | `≈ MOV A,B:ACI 05h:MOV B,A` | `ADC BL,5` |
| `0xCA` | OR B (imm) | `ORB #$05` | `OR B,$05` | `≈ LD A,B:OR 5:LD B,A` | `≈ OR A,#$05 (A=B)` | `≈ TXA:ORA #$05:TAX (B≈X)` | `or.8 b,$05` | `≈ MOV A,B:ORI 05h:MOV B,A` | `OR BL,5` |
| `0xCB` | Add B (imm) | `ADDB #$05` | `ADD B,$05` | `≈ LD A,B:ADD A,5:LD B,A` | `≈ ADD A,#$05 (A=B)` | `≈ TXA:CLC:ADC #$05:TAX (B≈X)` | `add.8 b,$05` | `≈ MOV A,B:ADI 05h:MOV B,A` | `ADD BL,5` |
| `0xCC` | Load D (imm) | `LDD #$1234` | `LD D,$1234` | `LD HL,$1234 (D=HL)` | `LDW X,#$1234 (D≈X)` | `≈ LDA #$12:LDX #$34 (no 16b)` | `ld.16 a,$1234` | `LXI H,1234h (D=HL)` | `MOV AX,1234h` |
| `0xCD` | - | - | | - | - | - | - | - | - |
| `0xCE` | Load Y (imm) | `LDY #$1234` | `LD Y,$1234` | `LD IY,$1234` | `LDW Y,#$1234` | `LDY #$34 (8-bit only)` | `ld.16 a,$1234 (Y≈a)` | `—` | `MOV DI,1234h` |
| `0xCF` | - | - | | - | - | - | - | - | - |
| `0xD0` | Subtract B (indexed) | `SUBB 6,X` | `SUB B,(X+6)` | `≈ LD A,B:SUB (IX+6):LD B,A` | `≈ SUB A,(6,X) (A=B)` | `—` | `sub.8 b,(dp+6)` | `≈ LXI H,X+6:MOV A,B:SUB M:MOV B,A` | `SUB BL,[BX+6]` |
| `0xD1` | Compare B (indexed) | `CMPB 6,X` | `CMP B,(X+6)` | `≈ LD A,B:CP (IX+6)` | `≈ CP A,(6,X) (A=B)` | `—` | `cmp.8 b,(dp+6)` | `≈ LXI H,X+6:MOV A,B:CMP M` | `CMP BL,[BX+6]` |
| `0xD2` | Sub-borrow B (indexed) | `SBCB 6,X` | `SBC B,(X+6)` | `≈ LD A,B:SBC A,(IX+6):LD B,A` | `≈ SBC A,(6,X) (A=B)` | `—` | `sbc.8 b,(dp+6)` | `≈ LXI H,X+6:MOV A,B:SBB M:MOV B,A` | `SBB BL,[BX+6]` |
| `0xD3` | Add D (indexed) | `ADDD 6,X` | `ADD D,(X+6)` | `—` | `≈ LDW Y,(6,X):ADDW —(reg-only)` | `—` | `≈ ld.16 b,(dp+6):add.16 a,b` | `≈ load (X+6) to D:DAD D` | `ADD AX,[BX+6]` |
| `0xD4` | AND B (indexed) | `ANDB 6,X` | `AND B,(X+6)` | `≈ LD A,B:AND (IX+6):LD B,A` | `≈ AND A,(6,X) (A=B)` | `—` | `and.8 b,(dp+6)` | `≈ LXI H,X+6:MOV A,B:ANA M:MOV B,A` | `AND BL,[BX+6]` |
| `0xD5` | Bit test B (indexed) | `BITB 6,X` | `BIT B,(X+6)` | `≈ LD A,B:AND (IX+6)` | `≈ BCP A,(6,X) (A=B)` | `—` | `≈ and.8 b,(dp+6) (flags)` | `≈ LXI H,X+6:MOV A,B:ANA M` | `TEST BL,[BX+6]` |
| `0xD6` | Load B (indexed) | `LDB 6,X` | `LD B,(X+6)` | `≈ LD A,(IX+6):LD B,A` | `≈ LD A,(6,X) (A=B)` | `—` | `ld.8 b,(dp+6)` | `≈ LXI H,X+6:MOV B,M` | `MOV BL,[BX+6]` |
| `0xD7` | Store B (indexed) | `STB 6,X` | `ST B,(X+6)` | `≈ LD A,B:LD (IX+6),A` | `≈ LD (6,X),A (A=B)` | `—` | `st.8 (dp+6),b` | `≈ LXI H,X+6:MOV M,B` | `MOV [BX+6],BL` |
| `0xD8` | EOR B (indexed) | `EORB 6,X` | `EOR B,(X+6)` | `≈ LD A,B:XOR (IX+6):LD B,A` | `≈ XOR A,(6,X) (A=B)` | `—` | `xor.8 b,(dp+6)` | `≈ LXI H,X+6:MOV A,B:XRA M:MOV B,A` | `XOR BL,[BX+6]` |
| `0xD9` | Add-carry B (indexed) | `ADCB 6,X` | `ADC B,(X+6)` | `≈ LD A,B:ADC A,(IX+6):LD B,A` | `≈ ADC A,(6,X) (A=B)` | `—` | `adc.8 b,(dp+6)` | `≈ LXI H,X+6:MOV A,B:ADC M:MOV B,A` | `ADC BL,[BX+6]` |
| `0xDA` | OR B (indexed) | `ORB 6,X` | `OR B,(X+6)` | `≈ LD A,B:OR (IX+6):LD B,A` | `≈ OR A,(6,X) (A=B)` | `—` | `or.8 b,(dp+6)` | `≈ LXI H,X+6:MOV A,B:ORA M:MOV B,A` | `OR BL,[BX+6]` |
| `0xDB` | Add B (indexed) | `ADDB 6,X` | `ADD B,(X+6)` | `≈ LD A,B:ADD A,(IX+6):LD B,A` | `≈ ADD A,(6,X) (A=B)` | `—` | `add.8 b,(dp+6)` | `≈ LXI H,X+6:MOV A,B:ADD M:MOV B,A` | `ADD BL,[BX+6]` |
| `0xDC` | Load D (indexed) | `LDD 6,X` | `LD D,(X+6)` | `≈ LD L,(IX+6):LD H,(IX+7) (D=HL)` | `LDW X,(6,X) (D≈X)` | `—` | `ld.16 a,(dp+6)` | `≈ LXI H,X+6:MOV E,M:INX H:MOV D,M:XCHG` | `MOV AX,[BX+6]` |
| `0xDD` | Store D (indexed) | `STD 6,X` | `ST D,(X+6)` | `≈ LD (IX+6),L:LD (IX+7),H (D=HL)` | `≈ LDW Y,X:LDW (6,X),Y (D≈X)` | `—` | `st.16 (dp+6),a` | `≈ XCHG:LXI H,X+6:MOV M,E:INX H:MOV M,D` | `MOV [BX+6],AX` |
| `0xDE` | Load Y (indexed) | `LDY 6,X` | `LD Y,(X+6)` | `≈ LD low,(IX+6):LD high,(IX+7) (no LD IY,(IX+d))` | `LDW Y,(6,X)` | `—` | `ld.16 a,(dp+6) (Y≈a)` | `—` | `MOV DI,[BX+6]` |
| `0xDF` | Store Y (indexed) | `STY 6,X` | `ST Y,(X+6)` | `≈ LD (IX+6),low:LD (IX+7),high (from IY)` | `LDW (6,X),Y` | `—` | `st.16 (dp+6),a (Y≈a)` | `—` | `MOV [BX+6],DI` |
| `0xE0` | Subtract B (extended) | `SUBB $1234` | `SUB B,($1234)`  | `≈ LD A,B:LD HL,$1234:SUB (HL):LD B,A` | `≈ SUB A,$1234 (B→use A)` | `≈ SEC:SBC $1234 (B→use A)` | `sub.8 a,(dp+$1234)` | `≈ MOV A,B:LXI H,$1234:SUB M` | `SUB BL,[1234h]` |
| `0xE1` | Compare B (extended) | `CMPB $1234` | `CMP B,($1234)`  | `≈ LD A,B:LD HL,$1234:CP (HL):LD B,A` | `≈ CP A,$1234 (B→use A)` | `≈ CMP $1234 (B→use A)` | `cmp.8 a,(dp+$1234)` | `≈ MOV A,B:LXI H,$1234:CMP M` | `CMP BL,[1234h]` |
| `0xE2` | Sub-borrow B (extended) | `SBCB $1234` | `SBC B,($1234)`  | `≈ LD A,B:LD HL,$1234:SBC A,(HL):LD B,A` | `≈ SBC A,$1234 (B→use A)` | `≈ SBC $1234 (B→use A; C=borrow)` | `sbc.8 a,(dp+$1234)` | `≈ MOV A,B:LXI H,$1234:SBB M` | `SBB BL,[1234h]` |
| `0xE3` | Add D (extended) | `ADDD $1234` | `ADD D,($1234)`  | `≈ LD HL,($1234):LD DE,(D val):ADD HL,DE — no 16-bit abs add` | `≈ LDW X,$1234... no 16-bit acc add of abs (ADDW X only #imm)` | `—` | `add.16 a,(dp+$1234)` | `≈ LHLD $1234:DAD rp (DAD adds rp only; need D in rp)` | `ADD AX,[1234h]` |
| `0xE4` | AND B (extended) | `ANDB $1234` | `AND B,($1234)`  | `≈ LD A,B:LD HL,$1234:AND (HL):LD B,A` | `≈ AND A,$1234 (B→use A)` | `≈ AND $1234 (B→use A)` | `and.8 a,(dp+$1234)` | `≈ MOV A,B:LXI H,$1234:ANA M` | `AND BL,[1234h]` |
| `0xE5` | Bit test B (extended) | `BITB $1234` | `BIT B,($1234)`  | `≈ LD A,B:LD HL,$1234:AND (HL):LD B,A (flags only; BIT n,r imm bit)` | `≈ AND A,$1234 (B→use A; flags only — BCP is imm-only)` | `BIT $1234 (flags from A&mem; but tests A not B)` | `≈ and.8 a,(dp+$1234) (test only)` | `≈ MOV A,B:LXI H,$1234:ANA M (flags only)` | `TEST BL,[1234h]` |
| `0xE6` | Load B (extended) | `LDB $1234` | `LD B,($1234)` | `≈ LD A,($1234):LD B,A` | `≈ LD A,$1234 (B→use A)` | `≈ LDA $1234 (B→use A)` | `ld.8 a,(dp+$1234)` | `≈ LDA $1234:MOV B,A` | `MOV BL,[1234h]` |
| `0xE7` | Store B (extended) | `STB $1234` | `ST B,($1234)` | `≈ LD A,B:LD ($1234),A` | `≈ LD $1234,A (B→use A)` | `≈ STA $1234 (B→use A)` | `st.8 (dp+$1234),a` | `≈ MOV A,B:STA $1234` | `MOV [1234h],BL` |
| `0xE8` | EOR B (extended) | `EORB $1234` | `EOR B,($1234)`  | `≈ LD A,B:LD HL,$1234:XOR (HL):LD B,A` | `≈ XOR A,$1234 (B→use A)` | `≈ EOR $1234 (B→use A)` | `xor.8 a,(dp+$1234)` | `≈ MOV A,B:LXI H,$1234:XRA M` | `XOR BL,[1234h]` |
| `0xE9` | Add-carry B (extended) | `ADCB $1234` | `ADC B,($1234)`  | `≈ LD A,B:LD HL,$1234:ADC A,(HL):LD B,A` | `≈ ADC A,$1234 (B→use A)` | `≈ ADC $1234 (B→use A; C=carry)` | `adc.8 a,(dp+$1234)` | `≈ MOV A,B:LXI H,$1234:ADC M` | `ADC BL,[1234h]` |
| `0xEA` | OR B (extended) | `ORB $1234` | `OR B,($1234)` | `≈ LD A,B:LD HL,$1234:OR (HL):LD B,A` | `≈ OR A,$1234 (B→use A)` | `≈ ORA $1234 (B→use A)` | `or.8 a,(dp+$1234)` | `≈ MOV A,B:LXI H,$1234:ORA M` | `OR BL,[1234h]` |
| `0xEB` | Add B (extended) | `ADDB $1234` | `ADD B,($1234)`  | `≈ LD A,B:LD HL,$1234:ADD A,(HL):LD B,A` | `≈ ADD A,$1234 (B→use A)` | `≈ CLC:ADC $1234 (B→use A)` | `add.8 a,(dp+$1234)` | `≈ MOV A,B:LXI H,$1234:ADD M` | `ADD BL,[1234h]` |
| `0xEC` | Load D (extended) | `LDD $1234` | `LD D,($1234)` | `≈ LD HL,($1234) (D=A:B; A←H,B←L)` | `LDW X,$1234` | `—` | `ld.16 a,(dp+$1234)` | `≈ LHLD $1234:MOV A,H:MOV B,L (D=A:B)` | `MOV AX,[1234h]` |
| `0xED` | Store D (extended) | `STD $1234` | `ST D,($1234)` | `≈ LD ($1234),HL (set H←A,L←B first)` | `LDW $1234,X` | `—` | `st.16 (dp+$1234),a` | `≈ MOV H,A:MOV L,B:SHLD $1234` | `MOV [1234h],AX` |
| `0xEE` | Load Y (extended) | `LDY $1234` | `LD Y,($1234)` | `LD IY,($1234)` | `LDW Y,$1234` | `—` | `ld.16 a,(dp+$1234)` | `≈ LHLD $1234 (no Y; use HL)` | `MOV SI,[1234h]` |
| `0xEF` | Store Y (extended) | `STY $1234` | `ST Y,($1234)` | `LD ($1234),IY` | `LDW $1234,Y` | `—` | `st.16 (dp+$1234),a` | `≈ SHLD $1234 (no Y; use HL)` | `MOV [1234h],SI` |
| `0xF0` | Load SP (indexed) | `LDSP 6,X` | `LD SP,(X+6)` | `≈ LD L,(IX+6):LD H,(IX+7):LD SP,HL` | `≈ LDW X,(6,X):LDW SP,X` | `—` | `≈ ld.16 a,(b+6):ld sp,a` | `≈ LXI H,addr:MOV E,M:INX H:MOV D,M:XCHG:SPHL` | `MOV SP,[BX+6]` |
| `0xF1` | Load SP (extended) | `LDSP $1234` | `LD SP,($1234)`  | `LD SP,($1234)` | `≈ LDW X,$1234:LDW SP,X` | `—` | `≈ ld.16 a,(dp+$1234):ld sp,a` | `≈ LHLD $1234:SPHL` | `MOV SP,[1234h]` |
| `0xF2` | Store SP (indexed) | `STSP 6,X` | `ST SP,(X+6)` | `≈ LD HL,$0:ADD HL,SP:LD (IX+6),L:LD (IX+7),H` | `≈ LDW X,SP:LDW (6,X),X` | `—` | `≈ ld.16 a,sp:st.16 (b+6),a` | `≈ LXI H,0:DAD SP:XCHG:LXI H,addr:MOV M,E:INX H:MOV M,D` | `MOV [BX+6],SP` |
| `0xF3` | Store SP (extended) | `STSP $1234` | `ST SP,($1234)`  | `LD ($1234),SP` | `≈ LDW X,SP:LDW $1234,X` | `—` | `≈ ld.16 a,sp:st.16 (dp+$1234),a` | `≈ LXI H,0:DAD SP:SHLD $1234` | `MOV [1234h],SP` |
| `0xF4` | Load SP (imm) | `LDSP #$0400`  | `LD SP,$0400` | `LD SP,$0400` | `LDW SP,#$0400` | `—` | `≈ ld.16 a,$0400:ld sp,a` | `LXI SP,0400h` | `MOV SP,400h` |
| `0xF5` | Add-carry D (imm) | `ADCD #$1000`  | `ADC D,$1000` | `≈ LD DE,$1000:ADC HL,DE (HL=D)` | `≈ ADC A,#$10:LD XL,A? →byte-wise: ADC B,#$00:ADC A,#$10 (D=A:B)` | `—` | `adc.16 a,$1000` | `—` | `ADC AX,1000h` |
| `0xF6` | Add-carry D (indexed) | `ADCD 6,X` | `ADC D,(X+6)` | `≈ LD E,(IX+7):LD D,(IX+6):ADC HL,DE (HL=D)` | `≈ ADC B,(7,X):ADC A,(6,X) (D=A:B, byte-wise)` | `—` | `adc.16 a,(b+6)` | `—` | `ADC AX,[BX+6]` |
| `0xF7` | Add-carry D (extended) | `ADCD $1234` | `ADC D,($1234)`  | `≈ LD DE,($1234):ADC HL,DE (HL=D)` | `≈ ADC B,$1235:ADC A,$1234 (D=A:B, byte-wise)` | `—` | `adc.16 a,(dp+$1234)` | `—` | `ADC AX,[1234h]` |
| `0xF8` | Sub-borrow D (imm) | `SBCD #$1000`  | `SBC D,$1000` | `≈ LD DE,$1000:SBC HL,DE (HL=D)` | `≈ SBC B,#$00:SBC A,#$10 (D=A:B, byte-wise)` | `—` | `sbc.16 a,$1000` | `—` | `SBB AX,1000h` |
| `0xF9` | Sub-borrow D (indexed) | `SBCD 6,X` | `SBC D,(X+6)` | `≈ LD E,(IX+7):LD D,(IX+6):SBC HL,DE (HL=D)` | `≈ SBC B,(7,X):SBC A,(6,X) (D=A:B, byte-wise)` | `—` | `sbc.16 a,(b+6)` | `—` | `SBB AX,[BX+6]` |
| `0xFA` | Sub-borrow D (extended) | `SBCD $1234` | `SBC D,($1234)`  | `≈ LD DE,($1234):SBC HL,DE (HL=D)` | `≈ SBC B,$1235:SBC A,$1234 (D=A:B, byte-wise)` | `—` | `sbc.16 a,(dp+$1234)` | `—` | `SBB AX,[1234h]` |
| `0xFB` | Shift D left by n | `ASLD #3` | `ASL D,$3` | `≈ (SLA L:RL H) ×3 (HL=D)` | `≈ SLLW X ×3 (X=D)` | `—` | `≈ ld c,$3:vshl.16 a` | `≈ DAD H ×3 (HL=D)` | `≈ MOV CL,3:SHL AX,CL` |
| `0xFC` | Shift D logical-right by n | `LSRD #3` | `LSR D,$3` | `≈ (SRL H:RR L) ×3 (HL=D)` | `≈ SRLW X ×3 (X=D)` | `—` | `≈ ld c,$3:vshr.16 a` | `≈ (ORA A:RAR on H, then RAR on L) ×3` | `≈ MOV CL,3:SHR AX,CL` |
| `0xFD` | Shift D arith-right by n | `ASRD #1` | `ASR D,$1` | `≈ SRA H:RR L (HL=D)` | `≈ SRAW X (X=D)` | `—` | `≈ shr.16 a + sign fix (no sar)` | `≈ MOV A,H:RAL:RAR? →manual sign-extend rotate (no SAR)` | `SAR AX,1` |
| `0xFE` | - | - | | - | - | - | - | - | - |
| `0xFF` | - | - | | - | - | - | - | - | - |

---

## Proposed

The **Proposed** column rewrites each BLIP cell by applying the rules below, cumulatively; a cell is left blank when no rule changes it. The goal is one consistent house style for BLIP assembly.

**R1 — Split the register off the verb.** Any operation that bakes its operand register into the mnemonic is written `VERB <reg>,…` (or just `VERB <reg>` when there is no operand). Covers loads, stores, 8-/16-bit ALU, the register read-modify-write forms, compares, and `LEA`.
  - `LDA #$05` → `LD A,$05`  ·  `SUBA 6,X` → `SUB A,(X+6)`  ·  `NEGB` → `NEG B`  ·  `LEAX 4,X` → `LEA X,X+4`
  - Mnemonics with **no** register designator keep their verb: the memory-operand RMW forms (`NEG $1234`, `CLR 6,X`) and the system ops (`DAA`, `SEX`, `ABX`, `ANDCC`, `LDMMU`, branches, `NOP`, …).

**R2 — Immediates as bare hex.** An immediate operand drops the `#` and is written as a `$`-prefixed hex literal. Applies to every instruction.
  - `SUBA #$05` → `SUB A,$05`  ·  `ANDCC #$EF` → `ANDCC $EF`  ·  `LDMMU #2` → `LDMMU $2`

**R3 — Memory is parenthesised; `(…)` means *dereference*.** Any operand that names a memory location is written in parentheses, and `(addr)` always means “the contents at `addr`”. A bare token is the value itself, so this also disambiguates immediates (`$05`) from memory (`($05)`). The address inside may be:
  - absolute — `($1234)`
  - a register, i.e. register-indirect (the register holds the address) — `(X)`, `(SP)`
  - register + displacement (Z80 order, register first) — `(X+6)`, `(SP-8)`
  - register + accumulator — `(X+B)`, `(X+D)`
  - with auto-increment / -decrement — `(X+)`, `(-X)`
  - a further level of indirection — `((X+6))`  ·  PC-relative — `(PC+6)`
  - `LDA 6,X` → `LD A,(X+6)`  ·  `LDA ,X` → `LD A,(X)`  ·  `STA $1234` → `ST A,($1234)`
  - **Bare = an address, not its contents.** Operands that *name an address* rather than dereference it stay unparenthesised: a `LEA` result and a jump/call target. `LEAX 4,X` → `LEA X,X+4`; `JMP ,X` → `JMP X`; `JMP $1234` → `JMP $1234`. (`JMP (X)` would instead jump *through* the pointer in X — BLIP's `JMP [,X]` → `JMP (X)`.)

**R4 — Register moves use `LD` / `XCHG`.** A register-to-register copy is spelled `LD dst,src`; a register exchange is `XCHG`. (The assembler emits the transfer/exchange opcode when both operands are registers — `LD` is overloaded over register, immediate, and memory operands, Z80-style.)
  - `TFR D,X` (D→X) → `LD X,D`  ·  `EXG A,B` → `XCHG A,B`
  - `LD` is `dst,src` where the old `TFR` was `src,dst`, so the operands **swap**; `XCHG` keeps its order (a swap is symmetric).
  - The privileged USP-banking forms become the USP variants: `TFRU` → `LD USP,X`, `EXGU` → `XCHG X,USP`.

Register-list operands (`PSHS A,B,X`, `PULS A,B,X`) and relative targets (`lbl`) are left unchanged.

**Decided.** Stores keep the R1 split form — `STA $1234` → `ST A,($1234)` — rather than the full Z80 `LD (…),A`, so BLIP keeps distinct `LD` / `ST` verbs (load vs. store stays visually explicit). Rules R1–R4 now cover the whole table; no operand kinds remain open.

---

## Addressing modes

This section compares how each architecture expresses the same **addressing modes** — the ways an instruction says *where its operand lives*. Every example loads the accumulator, so the operand notation is the only thing that varies. `≈` marks a different underlying mechanism or a multi-instruction stand-in; `—` marks a mode the architecture lacks.

**What each mode means:**

- **Immediate** — the operand is a constant baked into the instruction stream; no data memory is read to obtain the value. Shown in 8-bit and 16-bit widths.
- **Direct / extended (absolute)** — the instruction carries a full 16-bit address and accesses that fixed memory location.
- **Indexed, constant offset** — effective address = an index/base register plus a fixed signed displacement (`base + n`). The workhorse for C struct fields and stack locals (`n,SP`).
- **Register-indirect (zero offset)** — effective address = the index register itself (`base + 0`): a plain pointer dereference, `*p`.
- **Accumulator / register offset** — effective address = an index register plus the *value held in another register* (`base + A/B/D`): computes `array[i]` with no separate address arithmetic.
- **Auto-increment / -decrement** — dereference the pointer register, then step it (`*p++`), or step then dereference (`*--p`). Walks arrays and stacks with no extra instructions.
- **Indexed-indirect** — the computed address holds *another* address, which is then used: pointer-to-pointer and jump-table access, `**p`.
- **PC-relative (data)** — effective address = the program counter plus a displacement, so data references are position-independent (code relocatable without fixups).
- **Branch-relative (control)** — the branch target is the program counter plus a signed displacement, making control flow position-independent.
- **Inherent** — no operand at all; the instruction's effect is fully implied (e.g. `NOP`, `RTS`).

> The BLIP column below shows the **current** syntax; the agreed restylings are recorded in the [Proposed](#proposed) section above.

| Addressing mode | BLIP | Z80 | STM8 | 6502 | Magic-1 | 8080 | 8086 |
|---|---|---|---|---|---|---|---|
| Immediate (8-bit) | `LDA #$05` | `LD A,$05` | `LD A,#$05` | `LDA #$05` | `ld.8 a,$05` | `MVI A,5` | `MOV AL,5` |
| Immediate (16-bit) | `LDX #$1234` | `LD HL,$1234` | `LDW X,#$1234` | `—` | `ld.16 a,$1234` | `LXI H,1234h` | `MOV AX,1234h` |
| Direct / extended (absolute) | `LDA $1234` | `LD A,($1234)` | `LD A,$1234` | `LDA $1234` | `ld.8 a,(dp+$1234)` | `LDA 1234h` | `MOV AL,[1234h]` |
| Indexed, constant offset | `LDA 6,X` | `LD A,(IX+6)` | `LD A,(6,X)` | `≈ LDA $06,X` | `ld.8 a,(b+6)` | `≈ MOV A,M` | `MOV AL,[BX+6]` |
| Register-indirect (zero offset) | `LDA ,X` | `LD A,(HL)` | `LD A,(X)` | `≈ LDA ($10)` | `ld.8 a,(b)` | `MOV A,M` | `MOV AL,[BX]` |
| Accumulator / register offset | `LDA B,X` | `—` | `—` | `≈ LDA $1000,X` | `—` | `—` | `≈ MOV AL,[BX+SI]` |
| Auto-increment | `LDA ,X+` | `≈ LD A,(HL):INC HL` | `≈ LD A,(X):INCW X` | `—` | `—` | `≈ MOV A,M:INX H` | `≈ LODSB` |
| Auto-decrement | `LDA ,-X` | `≈ DEC HL:LD A,(HL)` | `≈ DECW X:LD A,(X)` | `—` | `—` | `≈ DCX H:MOV A,M` | `≈ STD:LODSB` |
| Indexed-indirect | `LDA [6,X]` | `—` | `—` | `≈ LDA ($10),Y` | `—` | `—` | `≈ MOV BX,[..]:MOV AL,[BX]` |
| PC-relative (data) | `LDA 6,PCR` | `—` | `—` | `—` | `—` | `—` | `—` |
| Branch-relative (control) | `BRA lbl` | `JR lbl` | `JRA lbl` | `≈ JMP lbl` | `br lbl` | `JMP lbl` | `JMP lbl` |
| Inherent (no operand) | `NOP` | `NOP` | `NOP` | `NOP` | `—` | `NOP` | `NOP` |
