scrpi/Fuzix-Compiler-Kit/(list of files, drawings)

Other design files:
logisim/blip.circ
logisim/build/control_word_decoder.circ
logisim/build/cpu.circ
logisim/build/microcode_store.circ
logisim/build/microsequencer.circ
logisim/build/opcode_lut.circ
logisim/build/uc_loader.circ
