scrpi/Fuzix-Compiler-Kit/(commit log)

2026-06-17 Add design docs: goals, requirements, ISA, hardware, decision log
    Establish the three-tier documentation model (goals -> requirements ->
    specs; conventions in AGENTS.md, auto-loaded via CLAUDE.md) and capture
    the design decisions made so far. Replaces the empty placeholder README.
    - goals.md: project goals G1-G8 and the priority hierarchy
    - requirements.md: testable requirements (R-* IDs) traced to goals
    - isa.md: register model, addressing modes, encoding map, calling
    convention, draft opcode map
    - hardware.md: datapath, internal MMU, microcoded writable control store,
    front panel, peripherals
    - decision-log.md: decisions D-01..D-19 with rationale
    Key decisions: discrete 74AHCT CPU; r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
2026-06-17 Drop FIRQ; move mode bit into CC; minimal interrupt frame
    Remove the fast interrupt (FIRQ) — it was inherited from the 6809
    influence with no requirement behind it (R-CPU-3 needs only a maskable
    IRQ + timer + NMI). Keep one maskable IRQ + NMI; every interrupt/trap
    stacks a minimal frame (PC+CC) and the handler saves registers via
    PSHS/PULS (matching the caller-saves ABI).
    Freeing the F mask and the now-redundant E bit lets the supervisor/user
    mode bit M live in CC (bit7), saved/restored automatically with CC and
    protected from user-mode writes alongside I. New CC = M - H I N Z V C
    (bit6 reserved). The SEF/CLF opcodes (0x0E/0x0F) are removed -> reserved.
    - isa.md: §2/§6/§8 (CC layout,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
2026-06-17 Add ADCD/SBCD and D multi-bit shifts (D-23)
    Adopt two capabilities surfaced by the Magic-1 gap analysis:
    - ADCD/SBCD: 16-bit add/subtract-with-carry on D (imm/indexed/extended)
    at 0xF5-0xFA, the chaining partners of ADDD/SUBD for multi-word (long)
    arithmetic (R-ISA-6, R-BUILD-1).
    - ASLD/LSRD/ASRD #n: shift D by an immediate count at 0xFB-0xFD, filling
    the missing 16-bit shift on D and the constant multi-bit shift case
    (R-ISA-6, R-BUILD-1). Runtime-register count deferred (D=A:B leaves no
    free count register; see isa.md s8.8).
    Both land in the 0xF0-0xFF wide-ops band. Updates matrix, band table,
    length notes, flag-effects, reserved list (~34 free), new s8.8 rationale,
    and decision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
2026-06-17 Note inter-map copy is interruptible software, not a block instruction
    Short spec note against R-MEM-4 in isa.md s6: bulk and cross-map copies
    are interruptible software loops (cross-map via windowed LDMMU), not a
    block-move instruction -- keeps interrupt latency bounded (R-CPU-3) and
    spends no opcode slot.
2026-06-17 Pin down microcode dispatch mechanism (D-24)
    Make 'dispatch on IR' concrete in hardware.md s4: the opcode forms the
    high bits of the microaddress and the postbyte mode field is OR'd into a
    base address for the shared EA sub-routine -- pure address wiring, no
    mapping PROM and no separate lookup memory on the dispatch path. A
    non-volatile lookup there would reintroduce the latency the ROM->SRAM
    boot-copy (D-03) exists to remove (R-CTRL-1/2/3).
    Decision-log D-24 records the rationale and the rejected alternatives
    (mapping PROM, boot-loaded SRAM map, PAL/PLA decoder, and fully flattening
    all control state into the address).
2026-06-18 Adopt assembly notation house style (D-25)
    Settle a single BLIP assembly syntax and apply it to the spec.
    - Add docs/isa-comparison.md: full 256-opcode cross-ISA grid (BLIP, Z80,
    STM8, 6502, Magic-1, 8080, 8086) with a Proposed column, the rule set
    (R1-R4), and an addressing-mode comparison. Non-normative.
    - Apply R1-R4 to docs/isa.md: verb/register split (LDA->LD A, TFR->LD,
    EXG->XCHG, CMPX->CMP X, ...), bare $-hex immediates, parens = memory
    (dereference), and LD/XCHG register moves. Rewrites the opcode matrix,
    addressing-mode table, postbyte/flag/relocation tables, and inline
    examples; adds s4.1 'Assembly notation'.
    - decision-log D-25 records the rules, rationale, the operan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
2026-06-18 Strengthen G7 and renumber goals to priority order (D-26, D-27)
    Sharpen G7 to "The ISA lives in microcode" — fully microcode-defined,
    EEPROM-reprogrammable, no board respin (new R-CTRL-4). Reprioritise so
    blinkenlights (G5) > defined interface (G6) > microcode (G7), then
    renumber all goals so the number equals the priority rank.
    Propagated the renumber across goals.md, requirements.md (all goal
    links + coverage table), decision-log.md, and hardware.md; verified no
    stale G-references remain elsewhere.
2026-06-18 Decide memory-mapped I/O (D-28)
    I/O is memory-mapped — no separate I/O space, no IN/OUT, no bus
    qualifier. Peripherals decode from a reserved 8 KB physical I/O page at
    0x00E000-0x00FFFF (frame 7, top of the low 64 KB). Device access is an
    ordinary LD/ST the MMU translates; mapping the I/O page is the same
    mechanism that isolates memory, so it gates devices too (D-18).
    Placing the page inside the reset identity window makes it reachable at
    boot with no MMU setup. Strengthened isa.md s6 to state plainly there is
    no "translation off" state — only the identity map of the low 64 KB at
    reset. Noted the reset-vector must avoid 0xE000-0xFFFF, and resolved the
    I/O-addressing open question in req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
2026-06-18 Draft functional CPU interface + exception-entry model (D-29, D-30)
    Add docs/interface.md: the 41-signal functional boundary (R-IF-1..6) —
    24-bit physical address out, 8-bit data, synchronous bus on a CLK input
    with /WAIT, separate /RD//WR, fully separate buses, fixed-vector
    software-polled interrupts (level /IRQ, edge /NMI), and a two-line
    /BUSREQ//BUSGRANT handshake. Debug interface deferred, with a wish-list
    (run/halt state, instruction-fetch marker).
    isa.md s6: interrupt/trap entry now sets CC.I (handler runs masked, RTI
    restores); new Exception vectors model — a fixed pointer-slot table for
    NMI/IRQ/SWI/traps that the kernel populates, with RESET a hardwired
    entry into boot ROM. Res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
2026-06-18 Decide reset vector & physical memory map (D-31)
    Reset entry is physical 0x000000 (boot ROM); reset state supervisor +
    IRQ-masked, SSP=0xE000. Boot-visible low 64 KB: ROM 0x0000-0x3FFF,
    RAM 0x4000-0xDFFF, I/O page 0xE000-0xFFFF; rest of physical is RAM. No
    ROM-disable latch needed (the MMU just unmaps ROM after boot).
    Boot model: a firmware monitor/loader inits hardware and loads the FUZIX
    kernel from a block device into RAM, builds the kernel map, fills the
    exception vector table, and enters the kernel. The kernel-location
    mechanism on the device is deferred.
    Logical: common at slot 7 (0xE000-0xFFFF) in every map, with the
    exception vector table at 0xFFE0-0xFFFF; user programs from 0x0000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
2026-06-18 Datapath working direction: LEFT/RIGHT/Z + scratch + constant-gen (D-35)
    Record the current (tentative) datapath direction and rename the buses:
    - hardware.md s2: LEFT bus (all registers) + RIGHT bus (two scratch
    registers + a constant generator 0/1/2/-1) into the ALU, results on
    the Z bus (renamed from R to avoid clashing with RIGHT). Marked
    tentative; open questions: address-increment vs overlap, and one
    scratch register vs two.
    - hardware.md s6: front-panel shadow registers (mirror each CPU register
    off the Z bus + per-register load strobes), so CPU registers need no
    display tap; this also cheaply realizes register visibility for the
    debug interface (D-13). Correctness need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
2026-06-18 Off-bus counters on PC/MAR/X/Y (D-36); AHCT/ACT family split (D-37)
    D-36: address increment is settled as off-bus +1 up-counters on PC, MAR,
    X, Y; USP/SSP and all +2/-1/-2 go through the ALU + constant generator,
    whose set is finalised as {-2,-1,0,+1,+2}. Counters help only where +1
    dominates (fetch, multi-byte stepping, byte-pointer loops); SP traffic is
    +-2/decrement dominated so a +1 up-counter would not help it. Shadow
    registers for the counters mirror the count strobe.
    D-37: 74AHCT is SSI-only (no MSI counters/ALU), so the core uses 74AHCT
    for SSI and 74ACT for MSI (counters = 74ACT163; ALU family with the part
    choice). Both are 5V TTL-input CMOS, one signaling regime. Refines D-02
    (le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
2026-06-19 Microcode control-word format: 80-bit horizontal control word (D-38)
    Specify the microcode control word and add docs/microcode.md (Tier-3 spec).
    - D-38: settle the control word as an 80-bit (10-byte), fully horizontal,
    registered word from the writable control store — every datapath field
    self-describing on the LED bank, per-flag flag control, with one
    context-typed wide-operand window (far-branch target / privileged SPECIAL,
    selected by USEQ_OP). Records the rejected widths (48/56/64/96-bit,
    two-level, explicit-next) and the Magic-1 cross-check as weighed
    alternatives. The 96- and 64-bit drafts were pre-commit exploration,
    squashed into this single decision entry.
    - docs/mi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
2026-06-19 Add Logisim Evolution control-block project (WIP)
    logisim/blip.circ (Logisim-evolution 4.1.0): work-in-progress
    visualisation of the microcode control block built against
    docs/microcode.md (microsequencer + control store).
    [blip.circ]
2026-06-20 Decision log: add Supersedes / Superseded by fields (schema + back-fill)
    Add two fields to every decision-log entry and define the immutability rule:
    once committed an entry is locked, with "Superseded by" the only field that
    may be appended retroactively (supersession is forward-looking); any other
    change needs explicit approval.
    Back-filled the supersession chain from a one-time analysis of the sequence:
    - D-02 superseded by D-37 (logic family, partial)
    - D-20 superseded by D-21 (encoding pages) and D-22 (interrupt/mode), partial
    - D-27 superseded by D-32 (renumber-the-log approach, partial)
    - D-34 superseded by D-35 (bus naming) and D-36 (address increment), partial
    - D-38 superseded by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
2026-06-20 Decision log: correct 8Kx8 SRAM size erratum (8192 words, not 4096)
    D-38 and D-39 stated "8Kx8 = 4096 words" / "4096-word store matching the
    on-hand 8Kx8 WCS SRAM depth". An 8Kx8 SRAM is 8192 words / 13 address
    lines; 4096 is half the part (what a 12-bit uPC addresses). Owner-approved
    retroactive fix to otherwise-frozen committed entries, with dated erratum
    markers preserved in-text for audit. Other "4096-word store" references
    (current 12-bit uPC range) are correct and unchanged.
2026-06-20 Add development workflow & toolchain spec; R-SIM/R-BUILD-3 requirements
    New Tier-3 spec docs/toolchain.md: structural Verilog on a 74-series
    timing cell library, two-engine simulation (Verilator functional +
    Icarus/STA worst-case timing), cocotb harness at the CPU boundary with
    external peripheral models, Python microcode assembler as single source
    of truth, and generated visualization (Yosys/netlistsvg/DigitalJS,
    GTKWave/Surfer). Tool claims web-verified; signal-integrity/ngspice
    deliberately out of scope.
    Regression model: a regression is something that used to work, broken by
    a change. Timing is a worst-case hardware property over all microcode, so
    the gate is asymmetric — microcode ch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
2026-06-20 Add engine-benchmark scaffold: 74-series cells + accumulator slice
    First executable step of the simulation-first build (D-10) and the
    "benchmark a representative slice" action (toolchain.md §10).
    - rtl/cells/ttl_283.v, ttl_574.v: gate-level 74-series cell models with
    specify timing (start of the R-SIM-1 cell library; delays provisional,
    toolchain.md §10.3).
    - sim/bench/add_accum.v: representative register->adder->register slice.
    - sim/bench/tb_icarus.v: timed run (Icarus -gspecify).
    - sim/bench/bench_verilator.cpp: zero-delay fast run (prints Mcyc/s).
    - sim/bench/README.md: what it measures + run commands.
    First-draft scaffold; not yet run. Measures two-engine throughput to
    replace t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
    [add_accum.v, bench_verilator.cpp, tb_icarus.v, ttl_574.v]
2026-06-20 Benchmark bring-up fixes: register power-on init, adder width, runner script
    - ttl_574.v: initial q_int = 0 (sim power-on/reset state). Without it the
    accumulator stays X and never toggles, making the Icarus timed run
    unrepresentative (near-zero switching activity).
    - ttl_283.v: width-extend operands so Verilator is WIDTHEXPAND-clean.
    - sim/bench/run.sh: committed runner that builds + times both engines with
    correct absolute paths (avoids inline shell-quoting / cwd pitfalls).
    - README: point to run.sh; reflect WSL-native clone (~/dev/blip).
    [ttl_574.v]
2026-06-20 ttl_574: edge-sensitive clk->Q specify (fixes Icarus acc=x)
    A flop has no combinational CLK->Q path; the full-path form (CLK *> Q)
    drove Q to x under iverilog -gspecify, so the accumulator never counted in
    the timed run. Use the edge-sensitive path (posedge CLK => (Q : D)) instead.
    [ttl_574.v]
2026-06-20 ttl_574: model clk->Q with intra-assignment delay (fixes Icarus acc=x)
    The specify clk->Q path (full or edge-sensitive) drove Q to x under
    iverilog -gspecify, so the accumulator never counted in the timed run.
    Use `q_int <= #8 D` instead: Icarus honors the delay, Verilator ignores it.
    Sequential-cell timing methodology (specify/SDF) remains open (toolchain §10.3/§10.4).
    [ttl_574.v]
2026-06-20 Reconcile toolchain/hardware/microcode specs to D-43 (single boot EEPROM)
    - toolchain.md: §2 diagram, §3.3 outputs (one image, chip-major layout),
    §3.5 (loader in the standard sim path; per-SRAM slices demoted to a bypass)
    - hardware.md: §4 boot-copy fan-out, §7 boot ROM (128 KB target with the
    SST39SF040 stock part as a grounded-upper-pins BOM note), §8 subsystem row
    - microcode.md: §3 note that the field definition fixes the bit positions
2026-06-20 Assembler: register-transfer front-end; rename blip.uasm -> blip.uc
    - uasm.py: new RTL front-end (statement parser + datapath binder + realizability
    checks); the bit-packer, image emit, and loader output are unchanged, so blip.uc
    compiles to byte-identical control words.
    - blip.uc: FETCH + LD A,(X+n8) re-cast in register-transfer notation.
    - toolchain.md §3.2 now describes the notation and points at microcode-source.md.
    - .opcode bindings use placeholder sequential indices (byte values unassigned, D-41).
2026-06-20 Boot-loader simulation (EEPROM + 13 SRAMs + fan-out loader); .gitignore
    - rtl/mem/{rom,sram}.v, rtl/ctrl/boot_loader.v: behavioral models of the single
    boot EEPROM, the control-store SRAMs, and the chip-major fan-out loader (D-43).
    - sim/loader/tb_loader.v: self-checking testbench — loads the single image, runs
    the loader, and verifies all 13 SRAMs reconstruct (106,496 bytes).
    - .gitignore: microcode/build, __pycache__, sim artifacts, *:Zone.Identifier.
2026-06-20 Add 61C64 (8Kx8 SRAM) datasheet — control-store SRAM candidate
2026-06-20 Migrate repo to the README layout (D-45)
    Realize the layout documented in README: rtl/ -> hdl/ (cells/ + boot/),
    microcode/uasm.py -> tools/uasm/, microcode/blip.uc -> microcode/src/,
    sim/loader/ -> sim/tb/loader/, non-normative material -> docs/reference/.
    - uasm.py now takes <source> and --field-def args with cross-tree defaults;
    the image still lands in microcode/build/.
    - run.sh paths + the microcode-source.md link updated to the new tree.
    - D-45 records the layout decision (canonical map in README.md); prior
    decisions' path references are left as historical.
    Verified at new locations: assembler (default + explicit args), check_fields,
    loader testbench (PASS), engine benchmark.
    Co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
2026-06-20 hdl/cells: real IS61C64AL SRAM and SST39SF010A flash models
    Replace the two placeholder control-store cell models with datasheet-
    faithful parts, and drive them from the boot-loader testbench through
    their real chip pins.
    is61c64.v (replaces sram.v) - 8Kx8 async SRAM (ISSI IS61C64AL), the part
    used for all 13 WCS + opcode-map chips. Real pinout (A, bidir I/O,
    /CE /OE /WE), data captured on the write-terminating edge, -10 grade
    read-path specify timing (tAA 10, tACS 10 / tHZCS 5, tDOE 6 / tHZOE 5).
    sst39sf010a.v (replaces rom.v) - 128Kx8 flash (SST/Microchip SST39SF010A),
    the single boot EEPROM. Real pinout (A0-A16, bidir DQ, CE#/OE#/WE#),
    async read, modeled read-only / pre-burned (the JED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
    [is61c64.v, sst39sf010a.v, tb_loader.v]
2026-06-21 tools/lint: structural-only DUT gate (D-46, R-SIM-5)
    The simulation is only meaningful if the simulated structure is the
    structure that gets built - a board of real chips wired together. Add a
    gate that enforces it: every hdl/ module outside the cell library must
    elaborate to nothing but real-chip cell instances + interconnect, with
    zero inferred logic.
    structural_lint.py - yosys reads hdl/cells/* (and every other DUT module)
    as blackboxes, elaborates each module, and asserts that no $-prefixed
    RTLIL cell exists (the form every synthetic operator / always / bare
    primitive takes on elaboration). A $ cell fails the gate and names the
    offending module.
    Known-synthetic placeholders are quarant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
2026-06-21 Rename microcode loader to uc_loader; fix stale .uasm refs
    The power-on circuit that copies the microcode image into the control-store
    SRAMs was named boot_loader, which collides with the (software) system boot
    loader still to come. Rename the module and file boot_loader -> uc_loader
    (keeping the hdl/boot/ directory) and update every consumer: the loader
    testbench, run.sh, the structural-lint quarantine entry, the cell-model and
    assembler comments, and the README/toolchain docs. "boot-copy" is kept as the
    descriptive term for the power-on copy action (and is locked into the
    decision log); the decision log retains the old module name as a historical
    reference, per D-45.
    Also fix three stale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
    [is61c64.v, sst39sf010a.v, tb_loader.v, uc_loader.v]
2026-06-21 Microcode loader as a structural netlist; cells named by real part number
    uc_loader was a behavioural placeholder; rebuild it as a structural netlist of
    real chips so it passes the D-46 structural-only gate, and clear the quarantine.
    uc_loader (hdl/boot/uc_loader.v):
    - 5x cd74act161 -> 17-bit ripple-carry address counter.
    - 2x sn74ahct138 -> 4->16 decode of seg = cnt[16:13] (no '154 available; the two
    halves use complementary enable polarities, so no inverter).
    - The decoder's seg-13 output is both the loading/done line AND the count enable,
    so the counter halts itself: no comparator, no loading flop, no glue gates.
    - Active-low reset (rst_n) drives '161 CLR# directly; active-low per-ch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
    [add_accum.v, cd74act161.v, sn74ahct138.v, sn74ahct574.v, sn74f283.v, tb_icarus.v, tb_loader.v]
2026-06-21 Always-timed simulation: Icarus -gspecify; every cell carries timing (D-47)
    The two-engine split had a leaky third mode - Icarus without -gspecify (zero
    delay) - which the loader regression used. It tests neither well: slower than
    Verilator, blind to timing. Make the split strict: Verilator (--no-timing) is the
    functional engine; Icarus is always run -gspecify (timed). The zero-delay Icarus
    mode is retired (D-47, R-SIM-6).
    - Every cell carries timing: combinational via specify, sequential via a # clk->Q
    delay (a specify clk->Q drives Q to x under Icarus). cd74act161 was the one
    untimed cell - added #15 clk->Q + ENT->RCO specify.
    - tools/lint/timing_lint.py enforces it: every hdl/cells/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
    [cd74act161.v, tb_icarus.v, tb_loader.v]
2026-06-21 docs(plans): add temporary plan to adopt Fuzix Compiler Kit toolchain
    Captures the SDCC->FCK pivot: what FCK is (Compiler-Kit + Bintools), the
    retargetable assembler/linker/object format we inherit, repo setup, the
    two-phase plan to start the BLIP assembler, open decisions (codegen vs G2,
    self-hosting requirement, vendoring), and the doc/decision ripple
    (supersede D-06, add R-BUILD-4). Non-normative; outside the three-tier chain.
    Claude-Session: https://claude.ai/code/session_01QimhpXyfxV78dCJzcY6SRH
2026-06-21 CPU scaffold: boot-then-run handoff, single entry point (hdl/cpu.v)
    First top-level that boots its microcode and runs. hdl/cpu.v wires the boot->run
    handoff entirely off uc_loader's `loading` signal - no separate state machine:
    - 4x sn74ahct157 -> the 13-bit control-store address mux (loading ? loader cnt : uPC)
    - cs_oe_n = loading (a wire): write during boot, read during run
    - 1x sn74ahct04 -> run = ~loading, releasing the micro-PC
    - 4x cd74act161 -> the micro-PC, held at 0 during boot, then walks the control store
    A system reset re-clears the loader, forcing loading back to 1 - so reset re-runs the
    copy for free; there is no explicit power-on-reset FSM (the reset *source* is an external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
    [cpu.v, sn74ahct04.v, sn74ahct157.v, tb_cpu.v]
2026-06-21 cpu: absorb the control store + boot-write path into the DUT; add `make test`
    The EEPROM, the 13 control-store SRAMs, and the boot-write glue were sitting in the
    testbench - real hardware in the harness. Move them into cpu.v so the design is
    self-contained and tb_cpu.v is a pure harness (clock, reset, checks).
    The deferred control-store data topology is now resolved as real chips:
    - 13x sn74ahct541 - per-chip boot-write isolation buffers. The EEPROM byte fans out to
    all 13 SRAMs during boot (enable = run); they tri-state during run so each SRAM drives
    its own control-word slice without contention. This is the price of the common-I/O
    is61c64 (a separate-I/O SRAM would collapse it to ~1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
    [cpu.v, sn74ahct32.v, sn74ahct541.v, tb_cpu.v]
2026-06-21 docs(plans): add CPU internal motherboard physical-construction plan
    Capture the converged design direction for the CPU's *internal*
    construction (distinct from the external functional interface): a flat
    motherboard that is passive interconnect + control-word decode glue only,
    with all architectural state on individually-respinnable per-function
    boards behind documented connector contracts.
    Covers the motivation (G5/G6 legibility), the hybrid interconnect
    topology (shared LEFT/Z plane, RIGHT local to ALU, central control
    decode, star clock, point-to-point links), the board inventory with
    per-board connector contracts, the centerpiece universal '163-based
    16-bit register board (D/X/Y/USP/SSP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
2026-06-21 viz: add `make viz` — generate the HDL schematic from the Verilog (P3)
    Realizes the schematic ("the plumbing") view from docs/toolchain.md §6:
    a generated, never-authored picture drawn straight from hdl/, so it
    cannot drift from the netlist.
    tools/viz/render.sh runs Yosys (reading hdl/cells/*.v as black boxes, so
    each 74-series part is one labelled box) -> JSON -> netlistsvg -> SVG,
    with an optional PNG preview. inout is coerced to input in the JSON for
    rendering only (netlistsvg's schema rejects inout; the design has real
    bidirectional buses — the SRAM io, the EEPROM dq). Prefers a native
    `yosys`, falls back to the pip `yowasp-yosys`.
    make viz renders cpu
    make viz TOP=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
2026-06-21 viz: add `make digitaljs` — interactive DigitalJS view from the Verilog (P3)
    Adds the second generated view from docs/toolchain.md §6: an interactive,
    signal-animated DigitalJS sim built from the same structural Verilog as the
    netlistsvg schematic, never authored.
    - tools/viz/digitaljs.{js,sh} + `make digitaljs` (default TOP=uc_loader):
    yosys (yosys2digitaljs's own synth flow, but `hierarchy -top $TOP` pinned so
    the requested module is selected deterministically) -> coerce inout->input
    (DigitalJS has no inout type) -> yosys2digitaljs core -> <top>.digitaljs.json
    + a self-contained <top>.html that loads DigitalJS's official browser bundle.
    - The whole cpu can't simulate: its share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
2026-06-22 cpu: factor into real microsequencer / store / map / decoder blocks; 12-bit µPC
    Split the cpu.v scaffold into the four blocks of the real control unit and
    populate them with real logic, not scaffold. All stages land make-test-green.
    12-bit micro-address (D-49, amends D-41; reversible): NEXT_ADDR/µPC 13->12 so each
    micro-address element is exactly three 4-bit chips (no 4th chip for one bit). Store
    is 4096 words; the 8K SRAMs run with A12 grounded. Rippled through control_word.toml
    (+SPARE_SEQ), uasm.py geometry, uc_loader (now four '161s), the specs, and the tests.
    Factoring (cpu.v becomes a thin integrator):
    - microsequencer.v -- real next-address logic for the fetch/branch core of US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
2026-06-22 microcode: rename the opcode→start-address map to the "opcode LUT" (D-50)
    Two distinct artifacts were both called the "opcode map": the ISA opcode map
    (isa/opcodes.toml, byte->instruction) and the microcode opcode->start-address map
    (the boot-loaded SRAM, D-40/D-41, that translates {DISPATCH_PAGE, IR} -> microroutine
    start address). The shared name was a recurring source of confusion, made worse by
    the MMU's own "map" sets sitting nearby.
    Rename the MICROCODE artifact to the opcode LUT everywhere current: the HDL module/file
    (opcode_map.v -> opcode_lut.v), its signals (lut_lo/hi/data/out), the assembler/test
    identifiers (SEG_LUT_LO/HI, LUT_ENTRIES, the clut array), control_word.toml, and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
2026-06-22 viz: `make viz` renders a schematic SVG for every HDL block
    render.sh previously read only uc_loader.v + cpu.v, so the factored blocks
    (microsequencer, microcode_store, opcode_lut, control_word_decoder) could not be
    rendered at all. It now enumerates every hdl/ module and, with no TOP, renders each
    one; `make viz TOP=<module>` still renders a single block. Each block is elaborated
    with its own source as the design and every other module read with -lib as a black
    box, so a sub-block instance draws as one labelled box — the same module-under-test
    view as the structural lint. Render-all is best-effort (one block that fails to
    elaborate doesn't stop the others; the run still exits nonzero), an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
2026-06-22 viz: label each chip with its purpose in the schematic
    netlistsvg titles a generic box with the part number only. Surface each
    chip's purpose by reading a `(* purpose = "..." *)` attribute off the HDL
    instance — authored in the source, so the label is generated and can't
    drift (toolchain.md P3) — and folding it into the box title as
    "<purpose> (<part>)", falling back to the instance name when absent.
    render.sh's existing JSON-munge step does the fold; the attribute is pure
    metadata (invisible to both lints, the timing build, and synthesis).
    Annotated cpu.v, microsequencer.v, and control_word_decoder.v; the SRAM
    arrays keep their indexed instance names via the fallback. Documented the
    c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
    [control_word_decoder.v, cpu.v, microsequencer.v]
2026-06-22 control store: give each block ownership of its own components
    Two related encapsulations, so each subsystem block is self-contained
    rather than wired up from glue in cpu.v. (cpu.v's hunks interleave the
    two, so they land together.)
    - uc_loader absorbs the boot EEPROM (param FILE). The loader is now a
    complete boot subsystem: clock + reset in, microcode streamed out to
    the WCS; cpu.v no longer threads rom_addr/rom_data. The standalone
    loader testbench is dropped — the loader is exercised on the cpu's
    standard path every run (toolchain.md §3.5), so a dedicated bench is
    redundant.
    - microcode_store absorbs the WCS address mux (3x '157) and its /WE
    strobe (3x '32); opcode_lut g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
    [cpu.v, microcode_store.v, opcode_lut.v, sn74ahct157.v, sn74ahct32.v, tb_cpu.v, tb_loader.v, uc_loader.v]
2026-06-23 tools/fcc: scaffold Fuzix-Bintools toolchain + BLIP assembler target
    Set up the ISA-level toolchain on the Fuzix-Bintools (assembler, linker,
    librarian, relocatable object format). The bintools/ submodule is pinned to a
    pristine upstream commit; the BLIP port is carried as a patch applied at build
    time, so we pin-and-patch rather than maintain a fork.
    The BLIP target (OA_BLIP arch id, TARGET_BLIP as.h block, as1-blip.c/as6-blip.c
    encoder + symbol table, Makefile rules) is an initial 6809 clone that builds and
    round-trips end to end, validating the target wiring. The ISA retarget
    (little-endian byte order, BLIP opcode map, dropping the U stack / DP direct
    page) follows in subsequent patches.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
2026-06-23 tools/fcc: retarget the assembler to the BLIP ISA (table-driven)
    Replace the 6809-clone starting point with a real BLIP encoder driven by the
    ratified opcode map. as1-blip.c parses a line into a normalized key (verb +
    operand form, e.g. "LD A,(SP+n)") and looks it up in blip-optab.h, emitting the
    0x80 page-1 prefix, opcode byte, and operand bytes little-endian (isa.md §3),
    picking the 8- vs 16-bit offset form by range. The §8.4 register-move selector,
    PSHS/PULS mask, branches, and the privileged USP-banking moves are all handled;
    the 6809 U stack / DP direct page are gone.
    blip-optab.h is generated from isa/opcodes.toml via a new
    gen_opcodes.py emit-asmtab subcommand (run by build.sh), so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
    [opcodes_test.py]
2026-06-23 tools/fcc: add Fuzix-Compiler-Kit submodule (pinned)
    Pin the C compiler kit (cc0/cc1/cc2 + the 680x backend family) as a submodule of
    the public fork, same pin-and-patch model as bintools. This is the base for the
    BLIP compiler backend (be-code-blip.c, cloned from the 6809 backend), wired in a
    follow-up.
    Claude-Session: https://claude.ai/code/session_01GnaLywn9aZJHnFiHccTRMK
2026-06-23 tools/fcc: BLIP C compiler backend (bring-up) + build wiring
    Add a cc2 backend (backend-blip.c) and cc1 target (target-blip.c) for the
    Fuzix Compiler Kit, registered in the driver (cc.c) and Makefile, carried as
    patches/compiler-kit/. Derived from backend-default.c (BLIP is little-endian,
    the kit default). Working value in D/B; structural codegen is native BLIP asm
    (segments, LEA-SP frame, RTS, JMP/LBEQ/LBNE branches, JSR helper calls,
    little-endian data) with native constant loads; arithmetic falls back to helper
    calls. The pipeline compiles real C (functions, locals, while/if/return,
    constants) to assembly that asblip assembles end to end.
    Reorganize patches/ into per-submodule dirs and e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
2026-06-23 tools/fcc: fix BLIP compiler backend bugs found in adversarial review
    Three parallel adversarial reviews (FCK contract / asblip syntax / BLIP ABI)
    found the following, now fixed in backend-blip.c:
    - CRITICAL: argument offsets omitted ARGBASE + frame_len, so every parameter
    addressed the wrong stack slot. gen_rewrite_node now adds frame_len + ARGBASE
    to T_ARGUMENT values (args now land at SP+2/SP+4/..., matching the 6809 port).
    - CRITICAL: 16-bit returns were left in D; isa.md §7 wants them in X. The
    epilogue now emits LD X,D for value-returning functions (skipped for void;
    8-bit returns stay in B).
    - MAJOR: moved the sp-accounting to the top of gen_node so it runs for natively
    ha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
2026-06-23 viz: generate a runnable Logisim Evolution .circ from the HDL
    New tool `tools/viz/logisim.{py,sh}` + `make logisim TOP=<block>`: reads the
    Yosys netlist and emits a Logisim Evolution 4.1.0 .circ that simulates, the
    same generated-not-authored way as `make viz`/`digitaljs` (toolchain.md P3).
    - Each cell becomes a real chip: a TTL-library part where 4.1.0 has the
    74-series number (12 of our 15 cells: 7404/08/32/86, 74138/139/151/153/
    157/161/283/541), else a general component (next: 574->Register,
    is61c64->RAM, sst39sf010a->ROM). Verilog-port -> DIP-pin maps per chip.
    - Chips face south so DIP pins land on two vertical columns (the verified
    EAST pin formula rotated by Logisim's Locati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
2026-06-23 tools/fcc: track the forks' 'blip' branch instead of build-time patches
    Move the BLIP assembler and compiler ports out of patches/ and onto a 'blip'
    branch in each fork (scrpi/Fuzix-Bintools, scrpi/Fuzix-Compiler-Kit). .gitmodules
    now sets branch = blip for both submodules and the superproject pins a commit on
    that branch, so a submodule checkout is the real source: it builds standalone and
    the port can be rebased onto upstream main and offered back as a PR.
    Drop patches/ and the patch-applying step from build.sh; build.sh still generates
    blip-optab.h from isa/opcodes.toml (the one derived artifact). README updated.
    Verified: deinit+reinit fetches the pinned blip commits from the forks, bu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
2026-06-23 tools/fcc: standalone BLIP emulator + crt0 + test harness
    Add a hand-written instruction-level BLIP emulator (tools/fcc/test/emublip.c)
    so compiled+linked BLIP programs can be run and asserted — the Verilog sim
    can't (datapath is still a scaffold). Mirrors how the Fuzix Compiler Kit tests
    its other backends (a C ISA emulator + magic-memory I/O harness).
    - emublip.c: flat 64K RAM, A/B(=D)/X/Y/SP/PC/CC, full flag semantics per
    isa.md §8.5, all addressing modes, PSHS/PULS (high-address-first, little-
    endian D), JSR/RTS, branches (base = end of instruction). Decode table is
    generated from isa/opcodes.toml (new gen_opcodes.py emit-emutab subcommand),
    so it can't drift from the opcode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
    [emublip.c]
2026-06-23 tools/fcc: bump compiler-kit to native codegen; add C regression suite
    - Bump the compiler-kit submodule to the blip-branch commit that adds native
    code generation for the cheap ops (no helper calls for ordinary integer C),
    including the fix for if/while/&&/||/! on char operands.
    - Add tools/fcc/test/ctests/*.c + run-ctests.sh: compile each test with the
    BLIP compiler, link with crt0 (no support library -- these are pure native),
    run on emublip, and assert exit 0 AND zero helper calls. Covers arithmetic,
    the dynamic-sp deep-expression case, comparisons, pointers/arrays, shifts,
    calls/recursion, and the char-boolean regression (which exit-code masking
    hid). All pass.
    - build.sh: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
2026-06-23 tools/fcc: bump compiler-kit to the support library; add lib tests
    - Bump compiler-kit to the blip-branch commit adding libblip.a (mul/div/rem/
    switch helpers + crt0) and the word-stacked char-argument fix (target-local:
    target_argsize/target_alignof, matching the 8080/z80 convention -- no
    shared-frontend change).
    - build.sh: also build the support library (libblip.a + crt0.o) into bin/.
    - test/run-libtest.sh: build libblip.a then compile/link/run each lib_*.c
    against it on emublip, asserting exit 0 (multiply, signed/unsigned divide+
    remainder, switch). All pass.
    - test/ctests/charargs.c: pure-native regression for char args followed by
    other params (the push/cleanup/layout-offse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
    [lib_div.c, lib_mix.c, lib_mul.c, lib_switch.c]
2026-06-23 tools/fcc: lower compound assignment & complex ++/-- natively
    Bump the compiler-kit pin to the backend-blip change that handles +=, -=, *=,
    /=, %=, &=, |=, ^=, <<=, >>= and ++/-- on complex lvalues (arr[i]++, (*p)++)
    in gen_node, instead of emitting the __pluseq / __postinc / ... helpers that
    libblip.a does not provide. Such C now links and runs on the emulator.
    Add test/lib_opeq.c (45 self-checking cases across every operator, int/char,
    signed/unsigned, and all lvalue shapes, plus pointer arithmetic and post/pre
    ++/--), run by run-libtest.sh. The suite previously had no compound-assignment
    coverage, which is why the gap went unnoticed.
2026-06-23 tools/fcc: 32-bit long support (data path, ops, helpers)
    Bump the compiler-kit pin to the backend-blip + supportblip change that
    implements 32-bit long: the native data path and arithmetic/bitwise/cast/
    compare/bool operations in the backend (D:Y working pair), plus the
    supportblip helpers for shifts, multiply, and signed/unsigned divide and
    modulo. long C now compiles, links, and runs on the emulator.
    Add test/lib_long.c (34 self-checking cases across arithmetic with carry/
    borrow, casts, signed/unsigned comparisons, bool, shifts, multiply, and
    signed/unsigned divide/modulo), run by run-libtest.sh.
2026-06-23 docs/isa §7: align the ABI to uniform stack passing and D:Y returns
    Change the spec to match the toolchain's canonical convention rather than
    the reverse:
    - Arguments: all passed on the stack, right-to-left, caller cleans up
    (D-51, amends D-19's leading-register-args rule) — one uniform rule
    regardless of arity, type, or variadic-ness, reached by (SP+n).
    - Returns: 32-bit long/float in the D:Y working pair (D-52, amends D-19's
    hidden-pointer return); struct/union not returned by value; 8-/16-bit
    returns in B/X unchanged.
    R-ABI-2 reframed to require one uniform passing rule; R-ABI-3 generalized
    to scalar-returns-in-registers-not-memory. D-19 marked superseded by
    D-51/D-52 (partia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
    [lib_long.c]
2026-06-23 viz: turn the Logisim generator into an LVS reconciler
    `make logisim` now GENERATEs a .circ only on first creation; thereafter it
    RECONCILEs and never overwrites your edits (KiCad schematic->PCB model).
    MODE=generate forces a fresh one; MODE=insert splices in missing chips.
    - Stable IDs: a chip's `label` (= sanitized HDL instance name) is its reference
    designator. Logisim preserves `label` but drops unknown attrs, so it's the only
    safe carrier; reconcile matches chips by label, never position.
    - Equivalence = an electrical net-partition diff, not a text diff. A wire is modeled
    as an equipotential: any node on its span (endpoint OR interior) joins the net,
    while a pure crossing stays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
    [control_word_decoder.circ, microsequencer.circ]
2026-06-24 viz: bus tunnels + splitters, and make bus the default Logisim generation
    The reconciler's electrical model is now bit-level: point-level "bundle" nets
    (wires + same-label tunnels) carry per-bit widths, and splitters remap individual
    bits between a combined bus and its fanout ends. Multi-bit tunnels join bit-for-bit;
    incompatible widths on one bundle are a width-mismatch DRC error. So a bus tunnel +
    splitters that replace N 1-bit tunnels is recognized as electrically identical, while
    a wrong bit-map / open bit / width clash surfaces as drift.
    - splitter_ends(): a transcription of Logisim's SplitterParameters geometry (combined
    end at loc; fanout pitch = spacing*10), verified against Logis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
    [control_word_decoder.circ, microsequencer.circ]
2026-06-24 microcode: generate the complete 462-opcode source
    Replace the FETCH + LD A,(X+n8) stub in microcode/src/blip.uc with the
    full instruction set — all 462 opcodes on both pages — in the register-
    transfer notation of docs/microcode-source.md. Generated from
    isa/opcodes.toml (the single source of truth) by the new
    microcode/gen_microcode.py, mirroring the project's generator-driven
    pattern (gen_opcodes.py, the field map, the Logisim reconciler). The
    per-mode and per-operation cycle sequences are hand-designed in the
    generator; the expansion over every opcode and the opcode->routine
    bindings are mechanical, so coverage is complete (462/462) and uniform.
    Source-notation only: the source uses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
2026-06-24 uasm: bind the full microcode notation + §11 realizability check
    Extend the assembler front end to bind every construct the complete
    blip.uc uses: memory writes ([MAR] <- src), the extended ALU (+c/-c,
    unary ~/-, asl/lsr/asr/rol/ror, const-gen PASS_R, the _ discard dest,
    A/B as the byte lanes of D), sequencer control (goto / if cond goto /
    call / return / return to fetch / wait) with condition parsing and
    label->address resolution, the loop counter (count -> uloop / uloop-- /
    uloop.zero), flag extras (z+, h), and the CC/MMU/lock clauses
    (cc/mi/map/pt/lock).
    The set_field / map_right guards make this a §11 realizability checker:
    a datapath-illegal word (two LEFT sources, a non-RIGHT operan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
2026-06-24 uasm: index the opcode LUT by real opcodes.toml bytes
    Carry the opcode byte in the .opcode directive — `.opcode page0 0x04
    LD A,(X+n8)` — emitted by gen_microcode.py from isa/opcodes.toml (D-48),
    and index the LUT by it: lut[{page,byte}] = routine start address, with
    range + uniqueness validation. Replaces the placeholder sequential
    indices, which misaligned dispatch for every opcode past the 0x80 prefix
    gap. Also bind page0[0x80] -> PREFIX_P1 (the page-1 prefix); unbound
    bytes stay 0 -> FETCH, a safe landing for an undefined opcode. Verified
    all 462 opcodes map to the correct routine.
2026-06-24 microcode: add an HTML microcode browser (make browser)
    microcode/gen_browser.py assembles blip.uc through uasm and emits a
    self-contained, dependency-free microcode/build/microcode.html:
    - left panel: the opcode->start-address LUT, each opcode a link that
    scrolls the store to its routine's first microword;
    - right panel: the control store, one microaddress per row, with a
    pinned header and frozen addr column. It is sequencer-focused — the
    USEQ_OP is a colour badge, branch/jump/call NEXT_ADDR is a click-to-
    jump link, and there is a cond column; then the 88-bit word as raw
    hex and as per-field columns, and a notes column (the source line).
    Each datapath field cell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
2026-06-24 microcode browser: gutter arrows, xrefs, inspector, lenses, staging overlay
    Add five tools to the HTML microcode browser:
    - Gutter jump-arrows: an SVG over the frozen addr column draws intra-
    routine branch/jump/call arrows (loops, PSHS/PULS skip ladders),
    lane-nested, with self-loop curls for the 1-word D-shift loops;
    redrawn from live row rects on scroll/filter/lens/resize and lit
    when an endpoint is the selected row.
    - Inbound xrefs: a per-target ↳N badge plus a full referenced-by list
    in the inspector (including the opcode LUT in-edges), each clickable.
    - Inspector panel: click a row for a bottom panel with the address /
    routine, source line, sequencer su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
2026-06-24 hdl: add memory_interface (MDR + external bus port) + timed bench
    The MDR register and the external memory bus port: the path by which the
    datapath reads and writes main memory (hardware.md §2/§3, interface.md §2-§4).
    Structural netlist of real chips (R-SIM-5): 4x '157 MDR source mux, 1x '574 MDR,
    2x '541 drivers. The MMU is the spec'd reset identity map (A = {8'h00, MAR}).
    New timed Icarus bench (sim/tb/mem/) drives the decoded control lines against a
    behavioural memory model in the harness (R-SIM-3) and asserts the full contract:
    /RD//WR framing off MEM_OP, CPU drives D only during a write, identity-mapped
    address, and a stage/WRITE/READ round trip that captures the device byte into
    M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
    [memory_interface.v, tb_mem.v]
2026-06-24 hdl: register board (PC/MAR) + real instruction fetch
    Build the universal '163-counter register board (cpu-physical-construction.md
    §6) and wire enough datapath into cpu.v to fetch a real opcode from memory,
    retiring the ir_drive injection for the fetch path.
    New cells (datasheet-sourced, CL=50pF MAX, image-verified):
    * cd74act163 — 4-bit sync counter with SYNCHRONOUS clear (the deterministic
    power-on reset element; the loader keeps the async '161).
    * sn74ahct244 — octal buffer in two independently-enabled 4-bit groups.
    register16 (4x '163 + 2x '244): the universal 16-bit register — load/count/hold
    superset storage with split per-byte load and a tri-state LEFT driver. Unit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
    [cd74act163.v, cpu.v, memory_interface.v, mk_fetch_image.py, register16.v, sn74ahct244.v, tb_cpu.v, tb_fetch.v]
2026-06-24 viz: hierarchical CPU .circ generation + headless Logisim load-linter
    Generate the whole CPU as a navigable hierarchical Logisim Evolution .circ:
    each HDL block (microsequencer, microcode_store, opcode_lut,
    control_word_decoder, uc_loader) becomes a subcircuit, and the cpu top
    instantiates them as boxes wired bit-by-bit by net name. The three non-TTL
    cells (sn74ahct574, is61c64, sst39sf010a) are DIP-faithful custom-chip
    subcircuits with 1:1 datasheet pinouts and a generated appearance.
    Routing:
    - >32-bit signals (the 88-bit control word, 64-bit datapath section) chunk
    into <=32-bit sub-buses inside blocks (Logisim caps a bus at 32 bits).
    - the cpu top carries no bus splitters (they collid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
    [control_word_decoder.circ, cpu.circ, microcode_store.circ, microsequencer.circ, opcode_lut.circ, uc_loader.circ]
2026-06-25 hdl: add the 16-bit ALU compute core (arith + logic + flags)
    The discrete '283-based ALU (hardware.md §9.2; one ALU for data/pointer/EA math).
    Structural netlist of real chips (R-SIM-5): 4x sn74f283 + AHCT logic/glue + a
    14x '541 tri-state result bus + a '157 width flag mux.
    Ops: PASS_L/PASS_R, ADD/ADC/SUB/SBC/NEG, AND/OR/EOR/COM. Subtraction is two's-
    complement add (RIGHT XOR-inverted, carry-in supplies the +1); carry follows the
    borrow convention on subtracts (C = carry_out XOR binv, so BLS/BCS work); overflow
    V = A_msb ^ B_msb ^ S_msb ^ carry_out; half-carry from the bit-3 boundary; W8/W16
    flags taken at the bit-7 / bit-15 boundary. The result reaches Z through per-op
    tri-state drivers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
    [alu.v, tb_alu.v]
2026-06-25 viz: XML-escape chip labels in the schematic SVG
    render.sh writes each cell's (* purpose *) text into the netlist JSON type field,
    which netlistsvg emits verbatim into an SVG <text> element with no escaping. A
    label containing & or < (e.g. "ADD&ALU_CIN", the "Z<-SUM" result-mux arrows) then
    produced malformed SVG. Escape the label (xml.sax.saxutils.escape) in render.sh's
    JSON-rewrite step so any purpose text is safe — fixed at the layer we own rather
    than banning characters from labels. All 9 block SVGs now validate as well-formed.
2026-06-25 hdl: split the ALU into sections, add SHIFT, add the RIGHT bus
    Split the monolithic alu.v into three functional sections over a shared,
    tri-state result bus, and complete the ALU with the shift unit and the RIGHT
    source bus. Structural netlists of real chips throughout (R-SIM-5).
    alu_arithmetic ADD/ADC/SUB/SBC/NEG + V / borrow-C / H (the '283 adder + glue)
    alu_logic AND/OR/EOR/COM
    alu_shift ASL/LSR/ASR/ROL/ROR (NEW) — width-aware fills, carry = bit out,
    V = result-sign XOR carry
    alu (top) PASS_L/PASS_R moves, the shared z bus, the N/Z reduction, and
    the flag selection (arith C/V, overridden by shift on a SHIFT op)
    Each sectio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
2026-06-25 hdl: CC register + condition generation; integrate the datapath (closes cond_drive)
    The condition-code board and the full datapath integration: the machine now
    computes, latches flags, and BRANCHES on the real computed condition — no
    injected conditions.
    CC board (structural, R-SIM-5):
    * cc_register — the 8-bit CC (M - H I N Z V C): per-flag write under FLAG_WE,
    V_SRC/C_SRC overrides, Z_ACCUM, the whole/AND/OR-mask writes (CC_WRITE_SRC),
    and the privileged M/I load (CC_MI_LOAD) with the user-mode interlock; resets
    to 0x90 (supervisor, IRQ masked).
    * cc_conditions — the 7 CC-derived branch predicates (Z/C/N/V/C_OR_Z/N_XOR_V/
    Z_OR_NXORV), i.e. the unsigned/signed com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
    [cc.v, cc_conditions.v, cc_register.v, cpu.v, mk_exec_image.py, tb_cc.v, tb_cpu.v]
2026-06-25 hdl: byte-lane steering (LEFT_LANE widen/move + Z_LANE byte lanes)
    Wire the two byte-lane steer paths into the datapath, closing the cpu.v
    scaffold gap where LEFT_LANE/Z_LANE were decoded but unconsumed.
    * left_lane.v — source-agnostic LEFT_LANE steer in front of the ALU
    (cpu-physical-construction.md §6.4a): FULL16 / zero-ext LOW / SIGN_EXT /
    HIGH_TO_LOW via 6x '157. cpu.v renames the wired-OR LEFT bus to left_raw
    and feeds the steered `left` to the ALU, so LEFT[15:8] no longer floats
    when MDR is the source.
    * z_lane.v — Z_LANE steer: promote Z[7:0] onto the high byte (2x '157) plus
    two active-high lane blockers (1x '04). SCR1/SCR2 latch from the steered
    z_l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
    [cpu.v, left_lane.v, mk_lanex_image.py, tb_lane.v, tb_lanex.v, z_lane.v]
2026-06-25 microcode+cc: privileged M/I controls (SEI/CLI, PULS CC, ANDCC/ORCC)
    Fix the three deferred CC-control findings with one coherent M/I redesign,
    faithful to isa.md §8.7 (M/I writable only in supervisor or on trap entry).
    * CC_MI_LOAD redefined HOLD/SET_ON_ENTRY/SET_I/CLR_I. SEI->SET_I (I<-1),
    CLI->CLR_I (I<-0) are now DISTINCT codes that touch I alone with M held
    (was: both collapsed to EXPLICIT, which loaded M and I from Z). #1
    * cc_register: a whole/masked CC write (CC_WRITE_SRC=WHOLE_Z/AND/OR) now
    carries M/I from src8[7]/[4], privilege-gated by M|SET_ON_ENTRY. So
    cc(whole) restores M/I for RTI/PULS CC, and cc(and)/cc(or) mask them in
    supervisor and hold them in u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
    [cc_register.v, mk_ccx_image.py, tb_cc.v, tb_ccx.v]
2026-06-25 hdl: full register file (D/X/Y/USP/SSP + ACTIVE_SP), LEFT sources, internal microconditions
    Close the remaining cpu.v scaffold gaps: the rest of the architectural register
    file and the sequencer's internal microconditions, so blip.uc runs with no
    condition injection.
    Register file (cpu.v):
    * D (A:B accumulator) — byte-lane-gated from Z_LOAD like the scratch regs.
    * X/Y — off-bus +1 counters (X_CTRL/Y_CTRL load/count/hold).
    * USP/SSP — full-16 registers, reached explicitly or as ACTIVE_SP.
    * sp_bank.v — resolves ACTIVE_SP to USP/SSP via use_ssp = CC.M | SP_BANK,
    handing each SP board one bank-resolved enable (no bank logic on the board).
    * LEFT sources CC (13) / IR_IMM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
    [cpu.v, mk_irqx_image.py, mk_regfile_image.py, mk_uloop_image.py, mmu_entry.v, sp_bank.v, tb_ccx.v, tb_cpu.v]
2026-06-25 review follow-up: 8-bit LEFT lane default; honest ULOOP/read-posting scaffold notes
    Adversarial review of a229853 (12 agents) confirmed 5 findings, all on the ULOOP
    load path. Fix the self-contained ones; document the rest accurately.
    * 8-bit LEFT float (medium): bind_left now defaults LEFT_LANE=LOW for the 8-bit
    LEFT sources CC/IR_IMM/MDR, so the high lane is a defined 0x00 (zero-extend)
    instead of the floating LEFT_RAW[15:8] that FULL16 passed into the ALU. The
    production `[MAR] <- CC` path is now defined; an explicit sext/low/high lane is
    unaffected. 16-bit sources keep FULL16.
    * ULOOP load (high) is a symptom of a deeper, pre-existing gap: MDR is not driven
    onto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
    [cpu.v, uloop.v]
2026-06-25 hdl(wave1): memory read posts on Z; single-cycle FETCH; real blip.uc runs end-to-end
    The load/store foundation. A read now posts its byte on Z combinationally during /RD
    (microcode-source.md §13 "parallel capture"), so `reg <- [PC]` latches the byte AND
    the flags in one microword — unblocking the whole LD/operand-fetch family.
    * memory_interface.v: zdrv '541 drives the LIVE pad d onto Z[7:0] gated by rd_n
    (NOT the stale mdr_q); zdrvh zero-extends Z[15:8]=0x00. New z_post output.
    * cpu.v: z_post joins the wired-OR Z bus. The ALU's default PASS_L would fight the
    post on a bare read word, so its enable is forced high during /RD (rd = ~rd_n via
    a spare inv lane; alu_op_n[0] |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
2026-06-25 microcode(wave2): ULOOP load co-drives Z — shift/MUL counts work from memory
    With reads now posting on Z (wave 1), the production `count -> uloop` idiom is made
    correct by loading uloop IN the word that drives the count onto Z.
    * build_dshift (ASL/LSR/ASR D,$n): the count read `_ <- [PC]; PC++ : z ; count ->
    uloop` posts n on Z and latches uloop <- ~n in one word; a `if z goto done`
    zero-trip guard leaves D unchanged for n=0 (the do-while floor).
    * MUL: stage the fixed count 8 on Z (SCR2: +2 -> 4 -> 8) and load uloop in the
    same word, then reuse SCR2 for the multiplier (the const-gen tops out at +2).
    Test: new shiftx runs real `LD A,$01 ; ASL D,$03` out of memory -> D=0x0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
    [tb_shiftx.v]
2026-06-25 hdl(wave3): micro-sequencer CALL/RETURN + µSR return register (D-42)
    Fill the deferred sequencer core. CALL saves µPC+1 and jumps to NEXT_ADDR; RETURN
    restores it — leaf micro-subroutines (depth-1 µSR), the natural home for the shared
    push/pop sequences repeated across JSR/BSR/traps.
    * 3x sn74f283 µPC+1 adder on upc_q (the '161 hides its own +1 and loads NEXT_ADDR on
    a CALL edge, so the return point must be computed separately).
    * 3x cd74act161 µSR (load-only on the CALL strobe op_n[6]); RETURN reads it via the
    formerly-dead slot-11 of the next-address '153 mux.
    * mux selects widened (dispatch|return / retfetch|return) and do_load extended with
    call|return — one '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
2026-06-25 hdl(wave4): the MMU — 8KB-page translate, identity-boot page table, map-select, LDMMU/STMMU
    New mmu.v owns A[23:0]: offset[12:0] passes through; addr[15:13] indexes a 16x11
    page table (8 kernel + 8 user, one is61c64); the 11-bit PPN drives A[23:13]. The
    table boots to the identity map (swept off the loader address during the boot copy,
    so reset = identity, "no translation-off state"), MMU_MAP_SEL picks the active map
    (FOLLOW_M=CC.M, kernel=map-bit-1; FORCE_KERNEL/USER), DIRECT_PHYSICAL bypasses the
    table with the identity PPN (vectors/reset), and LDMMU/STMMU write/read entries via
    MMU_ENTRY (mmu_entry.v gains the READ_ENTRY capture source).
    * cpu.v: connect the decoder's mmu_map_n (was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
    [cpu.v, mmu.v, mmu_entry.v, tb_mmu.v]
2026-06-25 hdl(wave5): trap-vector encoder + hardware IRQ I-masking
    RETURN_FETCH is now intercepted by a trap-vector priority encoder: when a trap is
    pending at the instruction boundary it redirects the µPC to that trap's fixed
    microroutine entry instead of the fetch entry 0. Fixed priority NMI > IRQ.
    * trap_encoder.v: priority resolve (NMI>IRQ) over hardwired entry constants ->
    trap_entry/trap_pending, gated by retfetch_active.
    * microsequencer: the RETURN_FETCH mux leg now selects trap_pending ? trap_entry : 0.
    * cpu.v: hardware IRQ I-mask — irq_masked = irq & ~CC.I feeds BOTH cond[9]
    (microcode.md §2 defines IRQ_PENDING "with CC.I clear") and the encoder, one
    source of truth (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
    [cpu.v, microsequencer.v, mk_irqx_image.py, mk_trap_image.py, tb_irqx.v, tb_trap.v, trap_encoder.v]
2026-06-25 hdl(wave6): fault detectors — PRIV_VIOLATION + ILLEGAL_OPCODE -> cond[13]/[14]
    The opcode LUT now carries two flag bits per entry: priv (lut_hi[4], set by the
    `.opcode ... priv` marker the generator emits for the 16 privileged opcodes) and
    VALID (lut_hi[5], set for every bound opcode). cpu.v forms the detectors:
    priv_violation = lut_priv & ~CC.M ; illegal_op = ~lut_valid
    and drives them onto cond[13]/[14] (formerly tied 0) — combinational off the current
    IR via ir_d, reusing spare lanes of the I-mask gate packages.
    * uasm: parse the `priv` marker; pack priv(bit12)+VALID(bit13) into the LUT entry;
    emit lut_hi & 0x3F. gen_microcode: emit `priv` from opcodes.toml.
    Test: new faul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
2026-06-25 hdl(wave7): TAS_LOCK + bus arbiter (/BUSREQ-/BUSGRANT, tri-state A//RD//WR)
    The system-bus arbitration the front panel / DMA needs (interface.md §4.6).
    * bus_arbiter.v: a registered grant — granted = /BUSREQ & ~TAS_LOCK & ~loading.
    Asserts /BUSGRANT, raises bus_oe_n (tri-state) and inhibits the CPU's own
    transfers (bus_inhibit = loading | granted).
    * cpu.v: new busreq_n/busgrant_n ports; A[23:0] driven through 3x '244 and /RD //WR
    through a '541, all gated by bus_oe_n so they float on a grant; TAS_LOCK
    (the dangling decoder bit) now blocks a grant so a read-modify-write stays atomic.
    Tests: arbx (/BUSREQ -> /BUSGRANT, A//RD//WR === z, then resume) and tasx (TAS_LOCK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
2026-06-25 cpu: derive internal `rd` from mi_rd_n, not the tri-stated /RD pin
    Adversarial-review finding (HIGH): the `inv` '04 that forms the internal
    `rd` (which suppresses the ALU PASS_L Z drive during a read) read the
    EXTERNAL rd_n pin. That pin is tri-stated by rwdrv on a bus grant
    (bus_oe_n=granted), so ~rd_n = X -> alu_passl_n = alu_op_n[0] | rd = X ->
    the ALU PASS_L /OE goes indeterminate -> the Z bus goes X, and any register
    the running microcode loads latches the X (reproduced in sim: SCR1/CC
    corrupted during a held grant).
    Feed the inverter from mi_rd_n instead — memory_interface's pre-tri-state
    /RD strobe, which bus_inhibit forces HIGH/idle during a grant and which
    never floats. In every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
2026-06-25 cpu: a held bus grant now stalls the whole core, not just the bus
    Adversarial-review finding (HIGH): `granted` fanned out only to the bus
    drivers (bus_oe_n) and memory_interface (bus_inhibit). It never reached the
    micro-sequencer or the datapath load strobes, so during a held /BUSGRANT the
    µPC kept clocking through microcode while every memory access was inhibited:
    a fetch/operand-read word drove the read-post on Z to high-Z and the running
    microcode latched garbage into IR/MDR/registers/CC. The machine corrupted
    its own architectural state instead of stalling — contrary to interface.md
    §4.6 ("the CPU initiates no cycles ... a held grant stalls it", R-IF-4) and
    bus_arbiter.v's own contra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
    [cc.v, cc_register.v, cpu.v, microsequencer.v, mk_arbx_image.py, tb_arbx.v, tb_cc.v]
2026-06-25 docs/plans: interim front-panel console spec
    Add docs/plans/front-panel.md — a TEMPORARY/NON-NORMATIVE, explicitly
    work-in-progress spec for the front panel, resting on two pivots: registers
    self-display on their boards (so the panel mirrors none), and the D-31 reset
    map (ROM at 0x000000, RAM at 0x004000, identity-mapped low 64 KB).
    The panel is two electrically-separate subsystems: a privileged debug console
    (bus mastering, run/stop, clock select, examine/deposit, LOAD-PC, EXECUTE,
    RESET, observation taps) and a functional switch/light I/O port on the system
    bus (8 sense in, 8-bit out / 2-hex) that must not touch the debug interface.
    Decided-so-far core: three switch banks (24 address +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
2026-06-25 sim/ctests: run compiled C programs on the gate-level CPU vs emublip
    A new ISA-level test area that bridges the BLIP C toolchain (tools/fcc) to the
    structural Verilog CPU: compile a C program (cpp/cc0/cc1.blip/cc2.blip/asblip/
    ldblip -b -C0 -> a raw flat image linked at 0, entered at PC=0), run it on the
    gate-level sim, and check stdout + exit against the emublip software emulator —
    the SAME image runs on both, so any divergence is a real gate/microcode bug.
    - tb_csim.v boots the real microcode into the WCS, $readmemh's the program
    image into a 64 KB memory at 0, and decodes the runtime's magic
    I/O page (0xFF00/01 print int, 0xFF02 putchar, 0xFF03 exit)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
    [bin2hex.py, fib.c, ret.c, tb_csim.v]
2026-06-25 microcode: stage every memory write through MDR (real-memory write protocol)
    The gate sim hung running compiled C: a function's RTS popped a zero return
    address and looped. Root cause was not RTS but the whole memory-WRITE path.
    A real device captures a write on /WR's rising edge with the address and data
    held valid through that edge (interface.md §4.2). The generated microcode wrote
    in a single microword — `[MAR] <- X` ("LEFT drives data") — but the write driver
    sources the REGISTERED MDR, so it emitted whatever was last staged, not X; and
    even with live data the byte isn't held past the cycle, `[MAR] <- low(PC); MAR++`
    moves the address at the capture edge, and two back-to-back pushe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
2026-06-25 isa: explicit register-move opcodes, replacing the selector movsel
    Register-register moves are now dedicated 1-byte opcodes instead of a generic
    `LD reg,reg` / `XCHG reg,reg` + a `movsel` register-selector postbyte:
    0xD8 LD D,X 0xD9 LD X,D 0xE9 XCHG D,Y 0xEA XCHG D,X
    These are the only pairs the C backend and the support library ever emit
    (enumerated across the compiler output + all linked asm). Each is a plain
    register pass on the existing buses (`D <- X`, `SCR1<-D; D<-Y; Y<-SCR1`, …) —
    NO new datapath and NO new control-word field, unlike the selector form which
    needed a runtime register-selector datapath (real chips). More legible and
    consistent with D-41 (flat ISA) and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
2026-06-25 uasm: A is D's HIGH byte (D = A:B); compiled-C bring-up still WIP
    isa.md §8 defines D = A:B with A the HIGH byte, and the §7 ABI returns an 8-bit
    value in B (the LOW half) — both matched by the emulator (getD = (A<<8)|B). But
    uasm bound A to D's LOW lane and B to the HIGH lane (swapped), so e.g. crt0's
    `ST B,($FF03)` (exit = the low byte) wrote D's HIGH byte. Swap the A/B lane
    mapping in parse_dest/bind_left so A=D.high, B=D.low, matching spec/ABI/emulator.
    Pure microcode lane convention — no HDL change. The two real-blip.uc benches that
    baked in the old order are updated: prog reads A at d_reg.q[15:8]; shiftx loads
    its 1 via `LD B` (the low byte). `make test` stays green.
    ===========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
    [tb_prog.v, tb_shiftx.v]
